Efrieza7/Cotxe_autonom/README_TOTAL.tex

\documentclass[11pt,a4paper]{article}

% Lletra Arial 11. Amb XeLaTeX o LuaLaTeX (a Overleaf: Menu > Compiler) es fa
% servir l'Arial de veritat; amb pdfLaTeX, Helvetica, que és pràcticament igual.
\usepackage{iftex}
\ifPDFTeX
  \usepackage[T1]{fontenc}
  \usepackage[utf8]{inputenc}
  \usepackage{lmodern}
  \usepackage[scaled=1]{helvet}
\else
  \usepackage{fontspec}
  \IfFontExistsTF{Arial}{\setsansfont{Arial}}{%
    \IfFontExistsTF{Liberation Sans}{\setsansfont{Liberation Sans}}{\setsansfont{TeX Gyre Heros}}}
\fi
\renewcommand{\familydefault}{\sfdefault}
\usepackage[spanish,es-noshorthands,english,catalan]{babel}
\usepackage{newunicodechar}
\usepackage[a4paper,margin=2cm,top=3.5cm,headheight=1.5cm,headsep=0.5cm]{geometry}
\usepackage{graphicx}
% Les imatges poden estar a la carpeta imatges/ o soltes al costat del .tex
\graphicspath{{imatges/}{./}}
\usepackage{booktabs}
\usepackage{float}
\usepackage{pdflscape}
\usepackage{amsmath}
\usepackage{xcolor}
\usepackage{listings}
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
\usepackage{setspace}
\usepackage{caption}
\usepackage[hidelinks]{hyperref}
% Els enllaços llargs es poden partir per qualsevol lloc i no surten del marge
\usepackage{xurl}

% Ela geminada (l·l) amb el punt volat ben ajustat
\newunicodechar{·}{\kern-0.12em\textperiodcentered\kern-0.12em}

% Lletres gregues dins del text
\newunicodechar{θ}{\ensuremath{\theta}}
\newunicodechar{δ}{\ensuremath{\delta}}
\newunicodechar{ω}{\ensuremath{\omega}}
\newunicodechar{Δ}{\ensuremath{\Delta}}

% Noms en català
\addto\captionscatalan{%
  \renewcommand{\contentsname}{ÍNDEX}%
  \renewcommand{\figurename}{Imatge}%
  \renewcommand{\listfigurename}{ÍNDEX D'IMATGES}%
  \renewcommand{\listtablename}{ÍNDEX DE TAULES}%
  \renewcommand{\refname}{BIBLIOGRAFIA}%
}

% Numeració fins a 4 nivells (p. ex. 4.2.4.1)
\setcounter{secnumdepth}{4}
\setcounter{tocdepth}{4}
% Títols com al README_TOTAL.md: les seccions amb una línia a sota
\titleformat{\section}{\normalfont\LARGE\bfseries}{\thesection}{0.6em}{}[{\vspace{-0.4ex}\titlerule}]
\titleformat{\subsection}{\normalfont\large\bfseries}{\thesubsection}{1em}{}
\titleformat{\subsubsection}{\normalfont\normalsize\bfseries\itshape}{\thesubsubsection}{1em}{}
\titleformat{\paragraph}{\normalfont\normalsize\itshape}{\theparagraph}{1em}{}
% Portada de cada bloc (Recerca, Electrònica, Mecànica, Programació)
\newcommand{\bloc}[1]{%
  \clearpage
  \refstepcounter{part}%
  \phantomsection
  \addcontentsline{toc}{part}{BLOC \thepart: #1}%
  \thispagestyle{empty}%
  \null\vfill
  \begin{center}
    {\Large\bfseries BLOC \thepart\par}
    \vspace{1em}
    {\Huge\bfseries #1\par}
  \end{center}
  \vfill\null
  \clearpage}
% Cada capítol comença en una pàgina nova (també si va just després d'un altre títol)
\let\origsection\section
\renewcommand{\section}{\clearpage\origsection}
\titlespacing*{\paragraph}{0pt}{3.25ex plus 1ex minus .2ex}{1.5ex plus .2ex}

% Capçalera de pàgina: logo de l'institut, nom del projecte i logo del cotxe
\usepackage{fancyhdr}
\usepackage{tabularx}
\pagestyle{fancy}
\fancyhf{}
% Tota la capçalera dins d'un requadre, amb línies verticals entre el logo
% de l'institut, el nom del projecte i el logotip del cotxe
\newcommand{\caplogo}[1]{\raisebox{-0.5\height}{\rule{0pt}{1.2cm}}\raisebox{-0.5\height}{}}
\fancyhead[C]{\begin{tabularx}{\headwidth}{|c|>{\centering\arraybackslash}X|c|}
  \hline
  \caplogo{logo_institut.png} & {\small\bfseries TREBALL DE RECERCA: COTXE AUTÒNOM} & \caplogo{logo_cotxe.png} \\
  \hline
\end{tabularx}}
\fancyfoot[C]{\thepage}
\renewcommand{\headrulewidth}{0pt}

% Cap paràgraf es parteix entre dues pàgines (tampoc després d'una equació)
\interlinepenalty=10000
% Una llista no comença a la pàgina següent de la frase que la presenta
\makeatletter\@beginparpenalty=10000\makeatother
\postdisplaypenalty=10000
\raggedbottom
% Les imatges i taules [H] queden sempre a la mateixa pàgina que el paràgraf
% d'abans. Amb \ambtextseguent dins de la figura, també amb el paràgraf de després.
\makeatletter
\newif\if@ambseguent
\newcommand{\ambtextseguent}{\global\@ambseguenttrue}
\renewcommand\float@endH{\@endfloatbox\penalty\@M\vskip\intextsep
  \if@flstyle\setbox\@currbox\float@makebox\columnwidth\fi
  \box\@currbox
  \if@ambseguent\penalty\@M\global\@ambseguentfalse\fi
  \vskip\intextsep\relax}
\makeatother

% Peus d'imatge i de taula en cursiva, com al README_TOTAL.md
\captionsetup{font=it,labelfont=it}

% Interlineat 1,15 i una línia en blanc entre paràgrafs
\setstretch{1.15}
\setlength{\parskip}{\baselineskip}
\setlength{\parindent}{0pt}
\setlength{\emergencystretch}{1em}

% Estil del codi
\lstdefinestyle{codi}{
  basicstyle=\ttfamily\small,
  keywordstyle=\color{blue!60!black}\bfseries,
  commentstyle=\color{green!40!black},
  stringstyle=\color{red!60!black},
  backgroundcolor=\color{gray!8},
  frame=single,
  rulecolor=\color{gray!40},
  breaklines=true,
  showstringspaces=false,
  columns=fullflexible,
  keepspaces=true,
  tabsize=4,
}
\lstset{style=codi}

\begin{document}

\hypersetup{pageanchor=false}
% Portada: logo de l'institut, títol, foto del cotxe i dades del treball
\newgeometry{margin=2cm}
\begin{titlepage}
  \setlength{\parskip}{0pt}
  \definecolor{granat}{HTML}{8B1E3F}
  \centering
  \par
  \vspace{2.5cm}
  {\color{granat}\rule{\textwidth}{1.5pt}\par}
  \vspace{0.8cm}
  {\Large\bfseries\color{gray!70!black} TREBALL DE RECERCA\par}
  \vspace{0.4cm}
  {\fontsize{40}{48}\selectfont\bfseries COTXE AUTÒNOM\par}
  \vspace{0.6cm}
  {\color{granat}\rule{\textwidth}{1.5pt}\par}
  \vspace{1.2cm}
  \par
  \vfill
  {\large\bfseries\color{granat} FET PER\par}
  \vspace{0.4em}
  {\large Sergi Rodríguez Garcia \enspace\textbullet\enspace Joan Pla Capdevila\\[0.2em]
    Enric Simó Benítez \enspace\textbullet\enspace Marcel Gonfaus Sant\par}
  \vspace{1.2cm}
  {\color{gray!50}\rule{\textwidth}{0.5pt}\par}
  \vspace{0.4em}
  \textbf{TUTOR:} Josep Maria Bergadà Fabregat\hfill\textbf{CURS:} 2n de Batxillerat, 2025-26\par
  \vspace{0.3em}
  Sabadell, 22 d’octubre de 2026\par
\end{titlepage}
\restoregeometry
\hypersetup{pageanchor=true}

{\setlength{\parskip}{0pt}\tableofcontents}
\clearpage

\section{ABSTRACT}

\subsection*{Castellà}
\begin{otherlanguage}{spanish}

El objetivo principal de este Trabajo de Investigación ha sido crear, a partir de los conocimientos de Bachillerato, un pequeño coche autónomo capaz de recorrer un circuito. Para llevar a cabo este proyecto se han usado conocimientos de programación, mecánica, electrónica, robótica e inteligencia artificial.

En la primera parte del trabajo se ha realizado una investigación sobre los coches autónomos y su evolución, con el objetivo de comprender su funcionamiento y adquirir los conocimientos necesarios para diseñar y construir nuestro propio coche autónomo. Posteriormente se han estudiado los recursos que se requieren para este trabajo, los componentes del coche y su chasis. Todo esto para poder desarrollar los programas para el vehículo.

Una vez finalizado el montaje, se han realizado diversas pruebas para comprobar que el coche funcione correctamente y corregir los errores cometidos en la parte de programación y de robótica.

En conclusión, este Trabajo de Investigación demuestra que, con los conocimientos adquiridos durante el Bachillerato, dedicación y mucho compromiso es posible crear un pequeño coche autónomo. Además, esta investigación ha permitido ampliar los conocimientos sobre programación, mecánica, robótica y poder comprender mejor el funcionamiento y las complejidades de los coches autónomos.

\end{otherlanguage}

\clearpage
\subsection*{Anglès}
\begin{otherlanguage}{english}

The main objective of this Research Project was to build a small autonomous car with the knowledge acquired during high school. The car was designed to go through a circuit without human assistance. To do this project, knowledge of programming, mechanics, electronics and artificial intelligence was used.

The first part of the work focused on researching autonomous cars and their evolution. The aim was to understand how they work and to acquire the knowledge needed to design and build our own autonomous car. Afterwards, the resources needed for the project, as well as the components of the car and the chassis were studied. All of this was done in order to develop the software for the car.

Once the building part was finished, several tests were carried out to make sure that the vehicle worked properly and to correct the errors that were found during testing.

To sum up, this Research Project demonstrates that, with the knowledge acquired during high school, a lot of dedication and perseverance it is possible to create a small autonomous car. Moreover, this investigation allowed us to expand our knowledge of programming, mechanics and robotics, while providing a better understanding of how autonomous vehicles work and their complexities.

\end{otherlanguage}

\section{INTRODUCCIÓ}

\subsection{La idea}

La idea de fer un projecte tan elaborat com el d’un cotxe autònom va sorgir d’una pluja d’idees en què volíem combinar diversos aspectes que agradessin a tots els membres del grup, com ara la programació, la mecànica o l’electrònica.

Al principi es va proposar fer un avió de control remot, però vam veure que s’havien d’aplicar molts conceptes nous que desconeixíem i vam decidir no fer-lo.

Quan es van presentar els treballs de recerca de 2n de batxillerat, n’hi va haver un que ens va cridar l’atenció a tots: un kart que es podia conduir. Va ser llavors quan ens va venir la idea de fer un cotxe que no estigués conduït per un humà sinó per un ordinador. Així que es va acordar que faríem un cotxe autònom fet per nosaltres des de zero.

\subsection{Sobre el projecte}

L’objectiu principal d’aquest treball és dissenyar i construir un cotxe autònom a escala capaç de recórrer un circuit delimitat per cons sense cap intervenció humana. La hipòtesi de partida és que, amb components de baix cost i els coneixements adquirits durant el batxillerat, és possible construir un vehicle que apliqui a petita escala els mateixos principis que fan servir els cotxes autònoms reals.

Els cotxes autònoms representen una de les tecnologies amb més potencial dins del sector de l'automoció. En els últims anys, empreses com Waymo, Tesla o Zoox han investigat i desenvolupat nombrosos prototips, fet que ha contribuït a l’evolució dels cotxes autònoms i ha despertat un gran interès per aquesta tecnologia. És un tema molt important, ja que podria reduir considerablement els accidents de trànsit produïts pels humans i millorar la conducció.

Aquest és un dels principals motius per a l’elecció d’aquest tema. A més, en els cotxes autònoms són essencials tots els àmbits que volíem combinar. I, com que som molt aficionats al món del motor i l’automobilisme, hem volgut que el disseny i la impressió 3D del cotxe fossin una part important del projecte. D’altra banda, vam pensar com es podria crear un cotxe autònom i quines dificultats ens causaria fer-lo.

\subsection{Organització}

Hem dividit el treball en quatre blocs principals, que corresponen a les diferents àrees que intervenen en un cotxe autònom:
\nopagebreak

\begin{itemize}
  \item \textbf{Recerca:} estudia què és un cotxe autònom, com ha evolucionat aquesta tecnologia i en quin punt es troba actualment. També analitza el que han fet diferents empreses del sector i fins a quin punt és viable aplicar aquesta tecnologia en el futur.
  \item \textbf{Electrònica:} analitza quins sensors existeixen, quins ens poden ser útils per al projecte i com s’han de connectar i alimentar perquè tot funcioni correctament.
  \item \textbf{Mecànica:} explica com funciona la mecànica d’un cotxe, especialment el sistema de direcció i la transmissió, i com hem dissenyat i fabricat les peces del nostre vehicle.
  \item \textbf{Programació:} explica com es programa un cotxe autònom i com hem utilitzat les dades dels diferents sensors perquè el vehicle es pugui localitzar, crear un mapa del circuit i seguir-lo.
\end{itemize}

Per assolir l’objectiu principal del treball, vam escollir les eines de cada bloc: Fusion 360 per al disseny 3D de les peces del cotxe, Inkscape per dissenyar el circuit, i ROS 2 i Python per a la programació.

Per dur a terme el treball, hem utilitzat una metodologia basada en la distribució de tasques segons les habilitats i els coneixements especialitzats de cada membre del grup. Els rols s’han assignat de la manera següent:
\nopagebreak

\begin{itemize}
  \item \textbf{Programació:} Enric
  \item \textbf{Mecànica:} Sergi
  \item \textbf{Electrònica i sensors:} Joan
  \item \textbf{Recerca de l’automobilisme autònom:} Marcel
\end{itemize}

Aquesta organització ens ha permès treballar durant l’estiu sense necessitat de fer reunions presencials constants, ja que cada membre ha pogut avançar en la seva àrea de manera independent.

Malauradament, cada integrant del grup ha tingut una manera diferent de treballar, i això es veu reflectit en el document: segons el bloc que es llegeixi, els continguts s’han explicat de maneres diferents.

Finalment, ens hem reunit per integrar les diferents parts del projecte, comprovar-ne la compatibilitat i posar en pràctica el sistema complet. Aquesta fase ha estat fonamental per coordinar la feina individual i aconseguir que tots els components funcionessin conjuntament.

\bloc{RECERCA}

\section{MARC TEÒRIC}

\subsection{Història dels cotxes autònoms}

Tot va començar l’any 1925, quan l’empresa nord-americana Houdina Radio Control va crear un cotxe sense ningú al volant. No es tractava d’un vehicle autònom, ja que estava controlat a través d’un sistema de radiocontrol, que funciona amb una persona que envia ordres de moviment i direcció a través d'un comandament.

Aquest projecte va inspirar moltes persones a imaginar noves possibilitats per al futur de l’automoció. Una d’aquestes persones va ser el dissenyador Norman Bel Geddes, qui l’any 1939 va presentar Futurama, una exposició on mostrava una possible ciutat del futur. En aquesta ciutat hi hauria milers de cotxes propulsats per camps electromagnètics i controlats automàticament. Tot això, amb l’objectiu de reduir els accidents a les carreteres.

Durant els anys següents, els avenços en informàtica, sensors i intel·ligència artificial van permetre desenvolupar sistemes autònoms cada cop més avançats. Durant les dècades dels vuitanta i noranta, Ernst Dickmanns, un professor i investigador alemany, va tenir un paper destacat en el desenvolupament d’aquestes tecnologies.

L’any 1987, Dickmanns va presentar el projecte VaMoRs. Es tractava de transformar una furgoneta Mercedes-Benz 508D en un vehicle autònom amb càmeres, sensors i un sistema informàtic molt avançat. Aquest prototip va arribar a velocitats de 90 km/h en autopistes alemanyes.

Anys més tard, el 1994, Dickmanns va crear el projecte VaMP, en el qual va modificar un cotxe Mercedes 500 SEL amb les tecnologies desenvolupades pel seu equip. El vehicle va dur a terme proves de llarga distància i va arribar a velocitats de 130 km/h pels afores de París. Gràcies a aquests avenços, la Comissió Europea va invertir en el projecte EUREKA Prometheus, un dels més importants sobre la conducció autònoma de l’època.

L’any 1995, Dickmanns va aconseguir unir Múnic amb Odense, Dinamarca, amb un Mercedes Classe S modificat. En total, el vehicle va recórrer més de 1.750 quilòmetres esquivant i avançant cotxes, tot de manera autònoma.

\begin{figure}[H]
  \centering
  
  \caption[{\protect\hyperref[imatge-1]{Projecte VaMP d'Ernst Dickmanns (Mercedes 500 SEL)}\protect\newline \textit{Font:} \protect\url{https://commons.wikimedia.org/wiki/File:VAMP.png}}]{Projecte VaMP d'Ernst Dickmanns (Mercedes 500 SEL)}\label{imatge-1}
\end{figure}

L’any 2004, DARPA, una agència nord-americana, va impulsar el desenvolupament dels vehicles autònoms amb la creació del DARPA Grand Challenge, una competició destinada a posar a prova diferents sistemes de navegació autònoma.

El 2009, Google va iniciar el seu projecte de vehicles autònoms, liderat inicialment per l’enginyer Sebastian Thrun, que havia participat anteriorment al DARPA Grand Challenge. En el projecte es van fer diverses proves amb vehicles equipats amb sensors, càmeres i sistemes informàtics capaços de detectar l’entorn i prendre decisions.

L’any 2015 Google va presentar Firefly, un prototip dissenyat per estudiar la conducció sense els controls convencionals d’un automòbil. Estava equipat amb diferents sensors i sistemes informàtics i anava sense volant ni pedals. Posteriorment, el projecte de Google es va convertir en Waymo, una empresa de tecnologia de conducció autònoma independent.

Waymo va continuar fent proves i desenvolupant els seus prototips, fins que l’any 2018 va llançar el seu servei de transport autònom en algunes zones determinades. Més endavant, el servei es va anar ampliant a més zones.

En conclusió, el desenvolupament dels cotxes autònoms ha estat progressiu i continuarà evolucionant a mesura que s’investiguin i desenvolupin noves tecnologies, amb l’objectiu de fer-los cada vegada més eficients i segurs.

\subsection{Què és un cotxe autònom?}

Els vehicles totalment automatitzats, també coneguts com a cotxes autònoms, són capaços de circular sense intervenció humana de manera continuada durant un període de temps. Per aconseguir-ho, utilitzen diverses tecnologies com sensors de percepció de l’entorn, càmeres, ordinadors i programes informàtics que els permeten prendre decisions. Són capaços de percebre l’exterior, interpretar-lo i prendre decisions en temps real per circular de manera segura.

\subsection{Com funciona un cotxe autònom?}

Per funcionar, els cotxes autònoms estan equipats amb diferents tecnologies que treballen conjuntament:
\nopagebreak

\begin{itemize}
  \item \textbf{Sensors de percepció de l'entorn:} a través de càmeres, radars, LiDAR i ultrasons, detecten possibles obstacles com ara vianants, cotxes i senyals de trànsit.
  \item \textbf{Sistemes de posicionament:} el GPS permet determinar la ubicació del vehicle.
  \item \textbf{Sistemes de comunicacions:} permeten intercanviar la informació necessària per a garantir una conducció automatitzada segura. Un exemple és la tecnologia V2X (\emph{Vehicle-to-everything}), que permet intercanviar informació amb altres vehicles, amb la infraestructura viària o amb altres elements de l’entorn.
  \item \textbf{Sistemes avançats de control:} gestionen les tasques del vehicle. Per exemple, per evitar que el cotxe perdi l’estabilitat s’utilitza el sistema de control electrònic d’estabilitat (ESC).
  \item \textbf{Sistemes d’aprenentatge automàtic:} també coneguts com a \emph{machine learning}, permeten aprendre de proves anteriors i prendre decisions per si mateixos sense ser programats amb instruccions fixes.
  \item \textbf{Algoritmes complexos:} formen part del programari que processa la informació recollida pels sensors. Per desenvolupar aquest programari es poden utilitzar diversos llenguatges com Python, C o C++, entre altres.
  \item \textbf{Controladors i actuadors:} reben instruccions del programari i controlen accions com la frenada, la direcció i l’acceleració.
  \item \textbf{Unitats de control i processadors:} executen el programari i transformen les dades dels sensors en ordres per al volant, l’accelerador i el fre.
\end{itemize}

En conjunt, aquestes tecnologies col·laboren per controlar el moviment del vehicle i realitzar les maniobres necessàries.

\subsection{Graus d’autonomia}

Segons la Societat d’Enginyers d’Automoció (SAE), hi ha sis nivells d’automatització, classificats segons el grau d’atenció i d’intervenció humana que es necessita durant la conducció, així com segons el desenvolupament i l’ús de les tecnologies utilitzades en el vehicle. Els sis nivells van del nivell 0 (manual) al nivell 5 (totalment automatitzat):
\nopagebreak

\textbf{GRAU 0 - MANUAL}

Conducció manual. El conductor s’encarrega de totes les tasques de conducció sense rebre l’ajuda de cap sistema complex.

\textbf{GRAU 1 - FEET OFF}

Conducció assistida. Un sistema d’assistència s’encarrega de controlar la direcció o l’acceleració, però no les dues alhora.

\textbf{GRAU 2 - HANDS OFF}

Automatització parcial. Un o diversos sistemes d’assistència controlen la direcció i l’acceleració.

\textbf{GRAU 3 - EYES OFF}

Automatització condicionada. Un sistema de conducció automatitzada realitza totes les tasques amb limitacions. El conductor ha d’estar pendent.

\textbf{GRAU 4 - MIND OFF}

Automatització alta. Un sistema de conducció automatitzada realitza totes les tasques de conducció.

\textbf{GRAU 5 - DRIVERLESS}

Automatització completa. Un sistema de conducció automatitzada realitza totes les tasques de conducció en qualsevol condició. No cal que el vehicle estigui equipat amb volant ni pedals.

\bloc{ELECTRÒNICA}

\section{SENSORS}

\subsection{LiDAR LD500}

El LiDAR LD500 serveix per saber a quina distància estan els objectes que hi ha al voltant del cotxe. Envia un làser i calcula el temps que triga a tornar després de rebotar contra un objecte.

En un cotxe autònom, s’utilitza principalment per detectar obstacles i evitar col·lisions. També ajuda el cotxe a saber com és l’espai que té al seu voltant.

Les característiques tècniques completes es poden consultar a la fitxa tècnica del component\footnote{\url{https://files.waveshare.com/wiki/D500-LiDAR-Kit/LDROBOT_STL-19P_Datasheet_EN_v1.0(1).pdf}}.

\subsection{Sense HAT 1.0.0}

El Sense HAT 1.0.0 és una placa que es pot connectar a una Raspberry Pi i que té diferents sensors. En un cotxe autònom pot servir per obtenir informació sobre el moviment i les condicions de l’entorn.

Té sensors per mesurar la temperatura, la pressió i la humitat, i també té una IMU, que és un sensor que detecta el moviment, la inclinació i la direcció del cotxe. De tots aquests sensors, en aquest projecte només s’utilitza la IMU; els de temperatura, pressió i humitat no es fan servir.

Les característiques tècniques completes es poden consultar a la fitxa tècnica del component\footnote{\url{https://pip-assets.raspberrypi.com/categories/676-raspberry-pi-sense-hat/documents/RP-008384-DS-1-sense-hat-product-brief.pdf}}.

\subsection{Sensors de proximitat HC-SR04 Pro}

L’HC-SR04 Pro és un sensor de distància per ultrasons. Emet un pols d’ultrasons i mesura el temps que triga a tornar l’eco després de rebotar contra un objecte. A partir d’aquest temps, i coneixent la velocitat del so, es pot calcular a quina distància es troba l’obstacle.

En el nostre cotxe n’hi ha dos, i s’utilitzen en el sistema de seguretat del control de la direcció per detectar parets o obstacles propers si la resta del sistema falla.

Les característiques tècniques completes es poden consultar a la fitxa tècnica del component\footnote{\url{https://sigmanortec.ro/en/ultrasonic-sensor-hc-sr-04p-3-55v}}.

\section{ACTUADORS}

\subsection{Motor GA12-N20 Encoder DC}

El GA12-N20 Encoder DC és un motor petit que serveix per fer girar les rodes del cotxe. Està format per un motor de corrent continu i un \emph{encoder}.

L’\emph{encoder} permet saber com està girant el motor, per exemple la seva velocitat i quantes voltes ha fet. Això és útil en un cotxe autònom perquè permet controlar millor el moviment i fer que el cotxe avanci a la velocitat desitjada.

Les característiques tècniques completes es poden consultar a la fitxa tècnica del component\footnote{\url{https://es.scribd.com/document/388716290/GA12-N20}}.

\subsection{Servomotor MG90S}

El servomotor MG90S és un petit motor que es controla mitjançant impulsos elèctrics: la durada de cada impuls indica la posició a la qual ha de girar, cosa que permet controlar amb precisió quants graus gira.

En el nostre cotxe, s’ha utilitzat per controlar la direcció de les rodes.

Les característiques tècniques completes es poden consultar a la fitxa tècnica del component\footnote{\url{https://towerpro.com.tw/product/mg90s-3/}}.

\section{CONTROLADORS}

\subsection{Raspberry Pi 4}

La Raspberry Pi 4 és el component principal que controla el cotxe. Rep la informació dels sensors, la processa i decideix què ha de fer el cotxe.

Per exemple, pot rebre informació del LiDAR i detectar que hi ha un obstacle. En aquest cas, pot enviar una ordre als motors perquè el cotxe freni o canviï de direcció.

Les característiques tècniques completes es poden consultar a la fitxa tècnica del component\footnote{\url{https://pip-assets.raspberrypi.com/categories/545-raspberry-pi-4-model-b/documents/RP-008341-DS-1-raspberry-pi-4-datasheet.pdf}}.

\subsection{Driver DRV8833}

El DRV8833 és un controlador (doble pont H) que serveix per controlar els motors. La Raspberry Pi envia les ordres al \emph{driver} i aquest controla la velocitat i el sentit de gir dels motors. No té pin de PWM separat: la velocitat es controla aplicant el PWM directament a les entrades xIN1/xIN2.

\begin{table}[H]
  \ambtextseguent
  \centering
  \caption{Connexions del DRV8833 i de l'encoder}\label{taula-1}
  \begin{tabular}{ll}
    \toprule
    \textbf{Senyal} & \textbf{GPIO (BCM)} \\
    \midrule
    AIN1 (motor A, amb encoder) & 5 \\
    AIN2 (motor A) & 6 \\
    BIN1 (motor B, sense encoder) & 26 \\
    BIN2 (motor B) & 16 \\
    Encoder fase A & 27 \\
    Encoder fase B & 17 \\
    \bottomrule
  \end{tabular}
\end{table}

El pin STBY (nSLEEP) del DRV8833 està connectat a VM, de manera que el \emph{driver} està sempre habilitat i no ocupa cap GPIO.

Això permet que el cotxe pugui avançar i anar enrere.

Les característiques tècniques completes es poden consultar a la fitxa tècnica del component\footnote{\url{https://www.ti.com/lit/ds/symlink/drv8833.pdf}}.

\section{ALIMENTACIÓ}

En aquest apartat es descriuen els components que proporcionen i regulen l’energia de tot el cotxe.

\subsection{Bateries OVONIC LiPo}

Les bateries OVONIC LiPo són les que proporcionen l’energia necessària perquè funcioni el cotxe. Alimenten els motors, la Raspberry Pi i la resta de components.

Les bateries LiPo tenen una bona relació entre pes i capacitat, per això són molt utilitzades en vehicles petits, drons i projectes de robòtica.

Tot i això, són perilloses i s’han de manipular amb molta precaució, ja que un curtcircuit pot fer que la bateria s’escalfi molt ràpidament i acabi explotant.

Les característiques tècniques completes es poden consultar a la fitxa tècnica del component\footnote{\url{https://www.ovonicshop.com/}}.

\subsection{Hobbywing BEC}

El Hobbywing BEC serveix per regular el voltatge que arriba als diferents components. La bateria dona una tensió que pot ser massa alta per a alguns components, i el BEC l’adapta perquè puguin funcionar correctament.

Així ajuda a protegir la Raspberry Pi i els altres components del cotxe.

Les característiques tècniques completes es poden consultar a la fitxa tècnica del component\footnote{\url{https://www.hobbywing.com/en/products/ubec-5a93}}.

\section{ESQUEMA DE CONNEXIONS}

Perquè tant els sensors com els controladors i els actuadors puguin funcionar, han d'estar tots ben connectats i ben alimentats. Per això el mapa de connexions és important. L'esquema complet es troba a l'\hyperref[annex-3]{Annex 3}.

Com es pot veure a l'esquema, la bateria va connectada directament al regulador (BEC), que en redueix la tensió a 5 V. Del regulador surten tres cables de 5 V i tres de GND. Una parella va a la Raspberry (pins 4 i 6), una altra al servomotor i l'última al \emph{driver} dels motors (DRV8833). Tant el Sense HAT com el LiDAR s'alimenten de la Raspberry, ja que no demanen gaire corrent.

El LiDAR està connectat a un adaptador USB-UART que permet connectar-lo a la Raspberry per USB. El Sense HAT, en canvi, va muntat directament a sobre del connector de 40 pins de la Raspberry.

Els motors es connecten a les sortides del \emph{driver}: el motor B a BOUT1 i BOUT2, i el motor A a AOUT1 i AOUT2. A més, el motor A té un \emph{encoder} per mesurar la velocitat de gir. L'\emph{encoder} envia els seus dos senyals als GPIO 27 (fase A, pin 13) i 17 (fase B, pin 11), s'alimenta amb els 3,3 V del pin 1 i té el GND connectat al pin 25. Finalment, la Raspberry controla el \emph{driver} a través de les entrades AIN1, AIN2, BIN1 i BIN2 (vegeu la Taula 1).

El servomotor, a part de l'alimentació, només té un cable, pel qual rep el senyal. Aquest cable està connectat al GPIO 4 (pin 7).

Els dos sensors de proximitat s'alimenten amb els 3,3 V del pin 17 i tenen el GND connectat al pin 39. Cada sensor utilitza dos GPIO: un per al Trig, que envia el pols d'ultrasons, i un altre per a l'Echo, que retorna el temps que triga l'eco. El primer sensor té el Trig al GPIO 13 (pin 33) i l'Echo al GPIO 19 (pin 35), i el segon té el Trig al GPIO 20 (pin 38) i l'Echo al GPIO 21 (pin 40).

\bloc{MECÀNICA}

\section{DESENVOLUPAMENT DEL DISSENY}

\subsection{El disseny}

\subsubsection{Inspiració del disseny del cotxe}

El disseny del cotxe es va basar en diversos xassís de cotxes vistos des de dalt per saber la forma i l’estructura que tenen. Més endavant, mentre es dissenyava en CAD, el disseny dibuixat originalment es va anar modificant fins a obtenir-ne una versió millorada i amb aspectes més innovadors.

\subsubsection{Programes de disseny 3D}

Avui en dia, hi ha molts programes de disseny i modelatge 3D, com ara FreeCAD, Tinkercad, Blender o Fusion 360. Alguns ja els havíem fet servir en cursos anteriors, però per fer aquest treball calien moltes funcions especials, així que hem optat per Fusion 360.

Fusion 360 és un programa de modelatge i disseny 3D amb llicència de pagament o pla gratuït, que fan servir empreses molt conegudes com Airbus o SpaceX per als seus prototips.

Hem triat aquest programa principalment per la practicitat i la varietat d’opcions que ens dona a l’hora de modelar i pel que fa a importar i exportar models 3D.

Aquí hi ha una taula comparativa dels programes:

\begin{table}[H]
  \centering
  \caption{Comparativa dels programes de disseny 3D}\label{taula-2}
  \begin{tabular}{lll}
    \toprule
    \textbf{Programa} & \textbf{Avantatges} & \textbf{Inconvenients} \\
    \midrule
    Tinkercad & Fàcil & Massa limitat \\
    FreeCAD & Gratuït i de codi obert & Interfície poc intuïtiva \\
    Blender & Molt potent & Poc orientat a enginyeria \\
    Fusion 360 & Paramètric i tècnic & Corba d’aprenentatge alta \\
    \bottomrule
  \end{tabular}
\end{table}

\subsubsection{Com ha anat avançant?}

Quan vam començar a fer l’esbós inicial, no vam preveure alguns errors, com el mecanisme de gir i l’espai que necessitaria, la posició del diferencial o com aniria connectat el motor, entre altres problemes d’ubicació i d’estètica.

\subsubsection{Imprevistos i millores en els prototips}

Mentre s’anava dissenyant, vam començar a fer prototips sencers del que seria el resultat final amb les impressores proporcionades per l’escola, però, com en tot projecte elaborat, es van detectar diversos aspectes de millora.

\paragraph*{Prototip \#1}

En el primer prototip el vehicle estava separat en dues parts. Aquesta configuració feia que l'estructura fos més propensa a enfonsar-se o deformar-se si havia de suportar massa pes a la part superior.

També es va provar de fabricar una reductora d'engranatges pròpia. Tot i això, el disseny dels engranatges no era correcte i aquests lliscaven entre ells, de manera que no transmetien el moviment correctament.

A partir d'aquests problemes es van decidir diverses modificacions.

En primer lloc, es va passar a fabricar el xassís en una sola peça, amb l'objectiu d'aconseguir una estructura més resistent. També es van reforçar algunes parts que podien acabar trencant-se amb l'ús.

Per al sistema de transmissió es va abandonar la reductora d'engranatges que s'havia dissenyat inicialment i es va passar a utilitzar un motor reductor.

\paragraph*{Prototip \#2}

En el segon prototip es van continuar fent modificacions a partir dels problemes i limitacions detectats anteriorment.

Es va decidir canviar el motor reductor usat anteriorment pel motor que es fa servir actualment, un motor GA12-N20 amb \emph{encoder} de 6 V.

També es va modificar la geometria del vehicle per millorar el sistema de gir i es va augmentar una mica la batalla del vehicle. A més, es va augmentar l'amplada de les rodes.

Un altre canvi important va ser la creació d'una nova peça en forma de L, dissenyada per connectar el servomotor amb la barra metàl·lica del sistema de direcció.

Aquestes modificacions es van fer amb l'objectiu de millorar la integració dels diferents elements mecànics i aconseguir un sistema de direcció més adequat per al vehicle.

\paragraph*{Prototip \#3}

En el tercer prototip, s’ha augmentat la llargada del cotxe a causa de la incorporació de sensors ultrasònics a la part posterior, i s’ha fet un suport per al LiDAR just a sobre del tren de direcció.

Finalment, hem col·locat dos motors per tenir més parell i una relació de transmissió de 2,5 voltes de roda per cada volta dels motors, junt amb un compartiment a la part inferior del cotxe per a la bateria.

\subsection{El resultat final}

En aquest apartat, es pot veure el resultat final del cotxe imprès i les seves dades.

\begin{figure}[H]
  \centering
  
  \caption[{\protect\hyperref[imatge-2]{Model final del cotxe}\protect\newline \textit{Fotografia pròpia}}]{Model final del cotxe}\label{imatge-2}
\end{figure}

\begin{table}[H]
  \centering
  \caption{Dimensions del cotxe}\label{taula-3}
  \begin{tabular}{ll}
    \toprule
    \textbf{Característica} & \textbf{Mesura} \\
    \midrule
    Longitud & 330 mm \\
    Amplada & 130 mm \\
    Distància entre eixos & 176,8 mm \\
    Amplada entre rodes & 130 mm \\
    Diàmetre de les rodes & 56 mm \\
    Alçada & 115 mm \\
    \bottomrule
  \end{tabular}
\end{table}

\section{MECANISMES}

Per poder fer que el cotxe realitzi algunes de les seves funcions bàsiques, com ara girar o moure’s, fan falta una sèrie de mecanismes que són emprats als cotxes reals.

\subsection{Geometria d’Ackermann}

Per al sistema de direcció del vehicle es va utilitzar una geometria basada en el principi d'Ackermann.

La geometria d'Ackermann permet que, quan el vehicle gira, la roda interior faci una trajectòria de radi menor que la roda exterior. Per aquest motiu, les dues rodes davanteres no han de girar exactament el mateix angle.

Aquesta geometria permet millorar el comportament del vehicle durant els girs i reduir el lliscament de les rodes.

En el nostre vehicle, aquest sistema es va integrar amb un servomotor que permet controlar el moviment de la direcció.

\begin{figure}[H]
  \ambtextseguent
  \centering
  
  \caption[{\protect\hyperref[imatge-3]{Geometria d'Ackermann}\protect\newline \textit{Imatge modificada. Font:} \protect\url{https://es.wikipedia.org/wiki/Archivo:Ackermann.svg}}]{Geometria d'Ackermann (modificada)}\label{imatge-3}
\end{figure}

Com es pot veure en la imatge, l’angle de la roda interior ($\theta_1$) és més gran que el de l’exterior ($\theta_2$).

En aquesta captura, es pot apreciar la geometria d’Ackermann des de Fusion 360.

\begin{figure}[H]
  \ambtextseguent
  \centering
  
  \caption[{\protect\hyperref[imatge-4]{Geometria d'Ackermann del nostre cotxe}\protect\newline \textit{Captura de Fusion 360}}]{Geometria d'Ackermann del nostre cotxe. Feta des de Fusion 360.}\label{imatge-4}
\end{figure}

El que està en vermell és on van connectades les rodes, el braç lila és on van unides les dues peces vermelles i la palanca blava és on van connectats el servomotor i el braç lila per poder girar.

\subsection{Aplicació de l’arquitectura d’Ackermann}

El sistema que es va utilitzar en el primer prototip era un sistema pinyó-cremallera. Però es va decidir canviar-lo perquè no funcionava com es necessitava. Posteriorment es va optar per utilitzar una barra articulada connectada al servomotor, la qual és travessada per uns fixadors que s’enrosquen a les parts blaves i vermelles de la imatge següent.

El servomotor permetia controlar la posició de la direcció i estava connectat mecànicament a una barra metàl·lica que transmetia el moviment a les rodes a través d’una barra que transformava la rotació del servomotor en moviment lineal.

La versió final ha quedat així:

\begin{figure}[H]
  \ambtextseguent
  \centering
  
  \caption[{\protect\hyperref[imatge-5]{Transmissió Ackermann-servomotor}\protect\newline \textit{Captura de Fusion 360}}]{Transmissió Ackermann-servomotor. Feta des de Fusion 360.}\label{imatge-5}
\end{figure}

Tot i que el sistema anterior semblava que funcionaria, era molt poc precís i no tenia prou força per poder girar correctament. Així que hem decidit canviar el mecanisme.

D'aquesta manera, el moviment del servomotor es transmet directament a la barra de gir i aquesta produeix el moviment de les rodes. El servomotor va instal·lat sobre la direcció, perquè d’aquesta manera es produeix un moviment més precís i directe.

\begin{figure}[H]
  \ambtextseguent
  \centering
  
  \caption[{\protect\hyperref[imatge-6]{Instal·lació final del servomotor}\protect\newline \textit{Captura de Fusion 360}}]{Instal·lació final del servomotor. Feta des de Fusion 360.}\label{imatge-6}
\end{figure}

\subsection{Transmissió del diferencial}

El grup diferencial d’un vehicle terrestre es va crear el 1827 per als cotxes impulsats a vapor. Servia per transmetre la força del motor als eixos de les rodes de forma asimètrica quan el vehicle girava en un revolt.

Avui dia s’utilitza en tots els vehicles terrestres (excepte motocicletes) i fa la mateixa funció que fa gairebé dos-cents anys, tot i que s’ha anat millorant al llarg dels anys.

Hem volgut aplicar-lo al nostre cotxe per la mateixa raó que la geometria d’Ackermann i perquè així sigui més estable i no derrapi als revolts fent que la roda de l’exterior giri més de pressa que la de l’interior.

Consta d’un conjunt d’engranatges anomenats planetaris, inserits dins d’una caixa metàl·lica i girats 90° entre ells, i una corona (un engranatge més gran) que està unida a la caixa. El moviment rotatori del motor es transmet a través d’un pinyó d’atac, que està connectat a 90° de la corona.

\begin{figure}[H]
  \ambtextseguent
  \centering
  
  \caption[{\protect\hyperref[imatge-7]{Funcionament del diferencial}\protect\newline \textit{Imatge modificada. Font:} \protect\url{https://www.motor.mapfre.es/consejos-practicos/consejos-de-mantenimiento/diferencial-coche/}}]{Funcionament del diferencial (modificada)}\label{imatge-7}
\end{figure}

Aquest és el nostre diferencial extret de Makerworld\footnote{Makerworld és una pàgina web on pots penjar i trobar dissenys per imprimir en 3D de forma gratuïta.} i modificat per nosaltres gràcies a lu\_print.

\subsection{Aplicació del diferencial}

En el nostre cas, el diferencial es va fer amb impressió 3D. El model inicial es va modificar per adaptar-lo al nostre vehicle. Es va fer un forat en cada un dels engranatges que van connectats als eixos de les rodes, ja que s’han utilitzat unes barres metàl·liques per transmetre el moviment directament a les rodes.

Aquesta modificació va permetre adaptar el diferencial al sistema de muntatge del nostre cotxe. Aquí es pot veure com ha quedat en el prototip final:

\begin{figure}[H]
  \centering
  
  \caption[{\protect\hyperref[imatge-8]{Diferencial del prototip final}\protect\newline \textit{Fotografia pròpia}}]{Diferencial del prototip final}\label{imatge-8}
\end{figure}

\section{IMPRESSORES 3D}

Per poder realitzar aquest projecte, s’han hagut d’utilitzar impressores 3D per crear-ho tot, des de les rodes fins al xassís. Hem fet servir impressores 3D de filament, ja que són les més adequades per fer el treball.

\subsection{Com funcionen?}

Una impressora 3D de filament diposita plàstic fos sobre una superfície llisa i calenta. El capçal, mogut per motors pas a pas i corretges, controla el flux de plàstic i la seva posició.

Aquest procés el va fent capa per capa fins que la peça està completada.

La màquina llegeix un codi escrit en G-code\footnote{El G-code és un llenguatge de programació utilitzat per controlar màquines automàtiques com impressores 3D, fresadores CNC, talladores làser i torns. Actua com un traductor que converteix un model digital en una sèrie d'instruccions que són les que llegeix la màquina.} generat per un laminador a partir de la peça que es vol imprimir. Aquest codi es descarrega o s’envia a la impressora per Wi-Fi, i la impressora imprimeix la peça automàticament.

\subsection{Quina impressora 3D hem utilitzat?}

Avui en dia, hi ha un gran ventall de marques d’impressores 3D, com ara Prusa, Creality o Bambu Lab. A la nostra disposició teníem la Bambu Lab H2D i la Bambu Lab P1S, les quals són de les impressores 3D més conegudes del mercat actual.

Tenen una qualitat i una rapidesa d’impressió excepcionals, cosa que ens garanteix una bona impressió i menys errades gràcies als seus sistemes d’intel·ligència artificial i CoreXY. El CoreXY és un sistema en què el capçal de la impressora es controla amb dos motors pas a pas independents i corretges.

La H2D es va utilitzar principalment per fabricar el xassís i les rodes, mentre que la P1S es va utilitzar per als engranatges, prototips petits i altres peces.

La utilització de dues impressores va permetre repartir la fabricació de les diferents peces segons les necessitats de cada impressió.

\subsubsection{Bambu Lab P1S}

La Bambu Lab P1S és una de les primeres impressores tancades que va fer Bambu Lab, i incorpora la tecnologia CoreXY. Destaca per la facilitat de muntatge, velocitat i fiabilitat. Inclou un volum d’impressió estàndard de 256 x 256 x 256 mm i porta un filtre de carboni per captar partícules perilloses en escalfar materials tècnics com l’ABS.

Només té un \emph{nozzle} (extrusor per on surt el filament plàstic desfet) i per canviar de color o material s’ha de fer manualment o utilitzar el sistema AMS (de l’anglès Automatic Material System), que ho fa automàticament.

\begin{figure}[H]
  \centering
  
  \caption[{\protect\hyperref[imatge-9]{Bambu Lab P1S}\protect\newline \textit{Font:} \protect\url{https://eu.store.bambulab.com/en/products/p1s}}]{Bambu Lab P1S}\label{imatge-9}
\end{figure}

\subsubsection{Bambu Lab H2D}

La Bambu Lab H2D és una de les primeres impressores tancades tot en un de tipus industrial, i incorpora la tecnologia CoreXY millorada respecte de la P1S.

Destaca per ser una plataforma híbrida de fabricació que combina impressió 3D ultraràpida, gravat i tall làser, i traçat a paper. Inclou un volum d’impressió molt més ampli, de 350 x 320 x 325 mm, i porta un potent sistema de ventilació amb filtre de carboni i cambra calefactada activa a 65 °C per treballar de manera segura amb materials tècnics avançats a altes temperatures.

A diferència de models anteriors, compta amb un doble \emph{nozzle} (dos extrusors independents), la qual cosa permet combinar materials rígids i flexibles com el TPU sense embussos.

\begin{figure}[H]
  \centering
  
  \caption[{\protect\hyperref[imatge-10]{Bambu Lab H2D}\protect\newline \textit{Font:} \protect\url{https://eu.store.bambulab.com/en/products/h2d}}]{Bambu Lab H2D}\label{imatge-10}
\end{figure}

\subsection{Paràmetres d’impressió}

Per a les impressions realitzades es van utilitzar principalment els següents paràmetres:

\begin{table}[H]
  \centering
  \caption{Paràmetres d'impressió}\label{taula-4}
  \begin{tabular}{ll}
    \toprule
    \textbf{Paràmetre} & \textbf{Valor} \\
    \midrule
    Alçada de capa & 0,2 mm \\
    Infill & 15 \% \\
    Nombre de parets & 3 \\
    Temperatura PLA & 220 °C \\
    Temperatura PETG & 255 °C \\
    Suports & Sí, en el xassís \\
    \bottomrule
  \end{tabular}
\end{table}

L’alçada de capa és la separació que hi ha entre les capes de les peces.

L’\emph{infill} (o farciment) és l’estructura interna de la peça: per estalviar temps i material, es genera un patró que suporta tota la peça i fa que sigui més resistent.

El nombre de parets és la quantitat de capes de plàstic que formen el contorn exterior de la peça, separant la superfície de l’\emph{infill} intern.

Els suports són estructures provisionals que aguanten les parts de la peça que queden suspeses a l’aire o tenen molta inclinació; sense ells, les peces sortirien malament.

\section{MATERIALS UTILITZATS}

La impressió 3D utilitza una gran varietat de materials, cadascun dels quals s’adapta a diferents tecnologies i aplicacions, des de la rapidesa i facilitat d'ús fins a la resistència mecànica o tèrmica.

\subsection{Quins materials teníem disponibles?}

Per poder realitzar el nostre projecte usant impressores 3D, teníem tres opcions:
\nopagebreak

\begin{itemize}
  \item \textbf{PLA (Àcid Polilàctic):} El material més comú i fàcil d'imprimir, s’imprimeix de 180 a 220 °C i és biodegradable. És ideal per a maquetes, decoració i prototips ràpids, però és poc resistent a la calor.
  \item \textbf{PETG (Polietilè tereftalat de glicol):} Té la facilitat d’impressió del PLA amb la resistència del material de les ampolles de plàstic, s’imprimeix de 220 a 255 °C. És més flexible que el PLA, resistent a l'aigua i als impactes.
  \item \textbf{ABS (Acrilonitril butadiè estirè):} Molt resistent i durador, aguanta bé les altes temperatures i es pot polir amb acetona, s’imprimeix de 230 a 250 °C. Requereix impressora tancada per evitar que es deformi durant la impressió.
\end{itemize}

\subsection{Materials per a cada peça}

Els principals materials utilitzats en la fabricació van ser PLA i PETG.

El PLA utilitzat era de Bambu Lab i Creality, mentre que el PETG utilitzat era de Creality.

La distribució dels materials va ser la següent:

\begin{table}[H]
  \ambtextseguent
  \centering
  \caption{Materials per a cada peça}\label{taula-5}
  \begin{tabular}{ll}
    \toprule
    \textbf{Peça} & \textbf{Material} \\
    \midrule
    Xassís & PLA \\
    Rodes & PLA \\
    Diferencial & PETG \\
    Engranatges & PETG \\
    Suports & PLA \\
    Altres peces & PLA \\
    \bottomrule
  \end{tabular}
\end{table}

El PLA es va utilitzar principalment en peces estructurals i altres parts del vehicle, mentre que el PETG es va utilitzar en peces que formen part del sistema de transmissió, com el diferencial i els engranatges.

\bloc{PROGRAMACIÓ}

\section{EXPLICACIÓ DE ROS 2}

ROS 2 (Robot Operating System 2) és un \emph{framework} de programari dissenyat principalment per al desenvolupament de sistemes robòtics. Permet executar diversos programes de manera simultània, compartir dades entre aquests programes i establir comunicació entre els diferents components del sistema.

ROS 2 funciona principalment mitjançant un sistema de \emph{nodes} i \emph{topics}. Cada \emph{node} és un programa que realitza una determinada funció, mentre que els \emph{topics} són canals de comunicació que permeten transmetre dades entre els diferents \emph{nodes}.

Un \emph{node} pot publicar dades en un \emph{topic}, és a dir, enviar informació, o pot estar subscrit a un \emph{topic}, de manera que rep les dades que es publiquen en aquest canal. D'aquesta manera, diferents programes poden treballar de forma independent però compartir la informació necessària.

A més dels \emph{nodes} i els \emph{topics}, un projecte de ROS 2 necessita una determinada estructura d'arxius i directoris perquè pugui ser compilat i executat correctament. Alguns directoris, com \texttt{build}, \texttt{install} i \texttt{log}, són generats automàticament durant el procés de compilació amb \texttt{colcon build}, que és la comanda per compilar els repositoris de ROS 2.

D'altra banda, hi ha arxius que formen part de l'estructura del paquet i que han de ser configurats pel programador. Entre aquests es troben \texttt{package.xml}, \texttt{setup.py} i, segons el tipus de paquet, \texttt{CMakeLists.txt}. També existeixen directoris com \texttt{src}, on es troba el codi font del projecte, i els diferents directoris interns del paquet.

En aquest projecte s'ha utilitzat la versió ROS 2 Jazzy. La guia oficial per instal·lar-la es pot trobar a: \href{https://docs.ros.org/en/jazzy/Installation.html}{Instal·lació de ROS 2 Jazzy}.

\begin{figure}[H]
  \centering
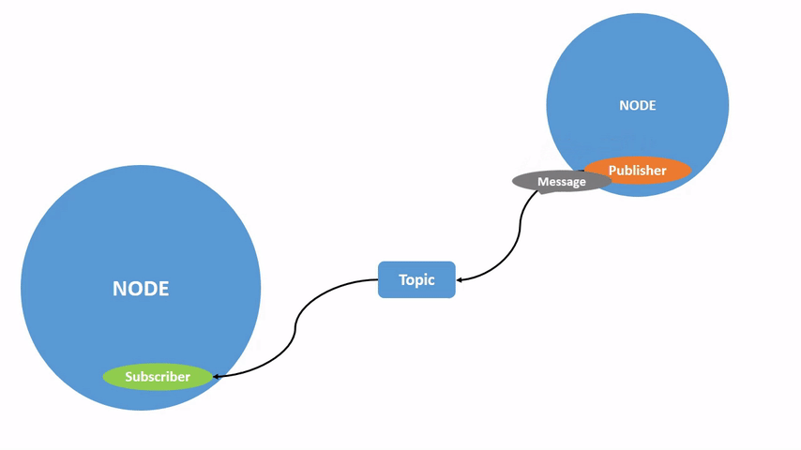
[picture p14: imatges/imatge_08_ros2_nodes_topics.png]
  
  \caption[{\protect\hyperref[imatge-11]{Exemple simple del funcionament de ROS 2}\protect\newline \textit{Font:} \protect\url{https://docs.ros.org/en/jazzy/Tutorials/Beginner-CLI-Tools/Understanding-ROS2-Topics/Understanding-ROS2-Topics.html}}]{Exemple simple del funcionament de ROS 2}\label{imatge-11}
\end{figure}

\subsection{Estructura d’un node}

El codi complet d'aquest exemple es troba a l'\hyperref[annex-1]{Annex 1}.

Aquest exemple mostra l’estructura bàsica d’un \emph{node} de ROS 2 desenvolupat en Python.

En primer lloc es troben els \emph{imports}, que incorporen les biblioteques i els tipus de missatge necessaris. En aquest cas, \texttt{rclpy} proporciona les eines necessàries per treballar amb ROS 2, \texttt{Node} permet crear el \emph{node} i \texttt{String} és el tipus de missatge utilitzat.

\begin{lstlisting}[language=Python]
import rclpy
from rclpy.node import Node
from std_msgs.msg import String
\end{lstlisting}

A continuació es defineix la classe del \emph{node}, que hereta de \texttt{Node}. Aquesta classe conté els elements que determinen el comportament del \emph{node}.

\begin{lstlisting}[language=Python]
class MyNode(Node):
\end{lstlisting}

El mètode \texttt{\_\allowbreak{}\_\allowbreak{}init\_\allowbreak{}\_\allowbreak{}()} és el constructor i s’executa quan es crea una instància del \emph{node}. En aquest apartat es configura el \emph{node} i es creen els elements de comunicació. En l’exemple es crea un \emph{subscriber}, que rep missatges del \emph{topic} \texttt{my\_\allowbreak{}topic}, i un \emph{publisher}, que permet publicar-hi missatges.

\begin{lstlisting}[language=Python]
    def __init__(self):
        super().__init__('my_node')

        self.subscription = self.create_subscription(
            String,
            'my_topic',
            self.listener_callback,
            10
        )
        self.publisher = self.create_publisher(
            String,
            'my_topic',
            10
        )
\end{lstlisting}

El \emph{subscriber} està associat a la funció \texttt{listener\_\allowbreak{}callback()}. Aquesta funció és un \emph{callback}, és a dir, una funció que ROS 2 executa quan es rep un missatge en el \emph{topic} al qual el \emph{node} està subscrit. És on es troba el codi executable com a tal.

\begin{lstlisting}[language=Python]
    def listener_callback(self, msg):
        print('Missatge rebut:', msg.data)
\end{lstlisting}

\newpage
Finalment, la funció \texttt{main()} s’encarrega de la inicialització i execució del \emph{node}.

\begin{lstlisting}[language=Python]
def main(args=None):
    rclpy.init(args=args)

    node = MyNode()
    rclpy.spin(node)
    node.destroy_node()
    rclpy.shutdown()
\end{lstlisting}

\section{PLANIFICACIÓ DEL CODI}

El sistema segueix la idea d’un SLAM (\emph{Simultaneous Localization and Mapping}): el cotxe calcula on és mentre construeix el mapa del circuit. El codi està dividit en quatre blocs, i cada bloc està format per diversos \emph{nodes} de ROS 2 que s’envien la informació a través de \emph{topics}:
\nopagebreak

\begin{enumerate}
  \item \textbf{Localització:} calcula la posició i l’orientació del cotxe a partir de la velocitat de les rodes (\emph{encoder}), de la IMU i de l’angle de direcció, utilitzant el Bicycle Model.
  \item \textbf{Mapatge:} llegeix el LiDAR, converteix les lectures en punts del pla, detecta els cons i els afegeix a un mapa global. Amb aquests cons també corregeix la posició calculada per la localització.
  \item \textbf{Planificació de la trajectòria (\emph{path plan}):} a partir del mapa de cons, calcula la traçada que ha de seguir el cotxe pel mig del circuit.
  \item \textbf{Control:} fa que el cotxe segueixi aquesta traçada: calcula l’angle de direcció (Pure Pursuit), manté la velocitat objectiu (PID) i envia les ordres al servomotor i als motors.
\end{enumerate}

A més, hi ha un sistema de seguretat amb sensors de proximitat que pot corregir la direcció si els altres blocs fallen.

Resumint, la informació circula així:
\nopagebreak

\begin{center}
  sensors $\rightarrow$ localització $\rightarrow$ mapatge $\rightarrow$ \emph{path plan} $\rightarrow$ control $\rightarrow$ motors i servo
\end{center}

Cada vegada que el LiDAR completa una volta, aquest cicle es repeteix, de manera que el cotxe treballa sempre amb les dades més recents. Als apartats següents s’explica cada bloc amb detall, i a l’apartat \ref{sec:organitzacio-global} es pot veure l’esquema complet de com es connecten tots els \emph{nodes}.

\section{LOCALITZACIÓ}

Aquest bloc s’encarrega de localitzar el cotxe i està format pels \emph{nodes}:
\nopagebreak

\begin{itemize}
  \item \texttt{src/\allowbreak{}codi\_\allowbreak{}principal/\allowbreak{}nodes/\allowbreak{}location/\allowbreak{}motor\_\allowbreak{}reader}
  \item \texttt{src/\allowbreak{}codi\_\allowbreak{}principal/\allowbreak{}nodes/\allowbreak{}location/\allowbreak{}imu/\allowbreak{}imu\_\allowbreak{}reader}
\end{itemize}

Que s'encarreguen de llegir les dades de la IMU i de l'\emph{encoder} del motor perquè es puguin utilitzar a la resta del sistema.

i el \emph{node} principal:
\nopagebreak

\begin{itemize}
  \item \texttt{src/\allowbreak{}codi\_\allowbreak{}principal/\allowbreak{}nodes/\allowbreak{}location/\allowbreak{}bicycle\_\allowbreak{}model/\allowbreak{}bicycle\_\allowbreak{}model}
\end{itemize}

Que s'encarrega d'utilitzar les lectures per calcular la posició del cotxe en tot moment.

\subsection{Bicycle Model}\label{sec:bicycle-model}

L'objectiu d'aquest \emph{node} és localitzar el cotxe, és a dir, calcular la seva posició (x,y) i la seva orientació al llarg del temps.

Per fer aquest càlcul, primer cal conèixer la velocitat del cotxe, que s'obté combinant les lectures de l'\emph{encoder} i de la IMU mitjançant un filtre complementari:
\nopagebreak

\begin{equation*}
  v = \alpha\,(v + a\,\Delta t) + (1-\alpha)\,v_{\text{encoder}}
\end{equation*}

On $\alpha$ és un valor entre 0 i 1 que indica quant es confia en l’acceleròmetre respecte a l’\emph{encoder}. L’acceleròmetre de la IMU detecta ràpidament els canvis de velocitat, mentre que l’\emph{encoder} evita que l’error que es comet en integrar l’acceleració s’acumuli amb el temps. A més, quan l’\emph{encoder} indica que les rodes estan aturades, la velocitat es considera zero, perquè el petit error de l’acceleròmetre no faci avançar el cotxe quan està quiet.

Utilitzant aquesta velocitat i l'angle de les rodes, el \emph{node} pot calcular com varia l'orientació del cotxe i, a partir d'aquesta, el seu desplaçament en els eixos x i y. Per fer-ho utilitza l'algoritme Bicycle Model, anomenat així perquè permet simplificar el moviment d'un cotxe representant-lo com si fos una bicicleta.

Aquest model considera que el moviment del vehicle depèn principalment de la velocitat, de l'angle de les rodes i de la distància entre els eixos. A partir d'aquests paràmetres es pot calcular el radi de gir mitjançant:
\nopagebreak

\begin{equation*}
  R = \frac{L}{\tan\delta}
\end{equation*}

On:
\nopagebreak

\begin{itemize}
  \item $R$ = radi de gir.
  \item $L$ = distància entre l'eix davanter i l'eix posterior.
  \item δ = angle de les rodes respecte de l'eix longitudinal del cotxe.
\end{itemize}

Un cop conegut el radi de gir, es pot calcular la velocitat angular del cotxe:
\nopagebreak

\begin{equation*}
  \omega = \frac{v}{R}
\end{equation*}

I, substituint el radi de gir:
\nopagebreak

\begin{equation*}
  \omega = \frac{v}{L}\,\tan\delta
\end{equation*}

% Fins aquí cap a la pàgina anterior (les fórmules no es poden separar del text)
\pagebreak

El temps transcorregut entre dues actualitzacions també es té en compte, de manera que en cada iteració es calcula una nova posició:
\nopagebreak

\begin{align*}
  x_{\text{nova}} &= x + v\cos\theta\,\Delta t \\
  y_{\text{nova}} &= y + v\sin\theta\,\Delta t
\end{align*}

I una nova orientació:
\nopagebreak

\begin{equation*}
  \theta_{\text{nova}} = \theta + \frac{v}{L}\,\tan\delta\,\Delta t
\end{equation*}

Així, el \emph{node} estima contínuament la posició i l'orientació del cotxe a partir del seu moviment.

\begin{figure}[H]
  \centering
  
  \caption[{\protect\hyperref[imatge-12]{Dibuix orientatiu del Bicycle Model}\protect\newline \textit{Feta amb IA (Claude)}}]{Dibuix orientatiu del Bicycle Model}\label{imatge-12}
\end{figure}

\section{MAPATGE}

Aquest bloc construeix el mapa del circuit a partir de les dades de localització del cotxe, prèviament processades, i de les dades obtingudes mitjançant el LiDAR.

El codi encarregat de llegir el LiDAR es troba a \texttt{src/\allowbreak{}lidar\_\allowbreak{}drivers} i no ha estat desenvolupat pel programador del grup. Es tracta del codi recomanat pel fabricant d’acord amb les especificacions del sensor (\emph{datasheet}). Aquest codi publica, després de cada volta completa del LiDAR, les dades de lectura en forma de coordenades polars (distància i angle) al \emph{topic} \texttt{/\allowbreak{}ldlidar\_\allowbreak{}node/\allowbreak{}scan}, amb missatges de tipus \texttt{LaserScan}.

Els \emph{nodes} que formen el bloc de mapatge són:
\nopagebreak

\begin{itemize}
  \item \texttt{src/\allowbreak{}codi\_\allowbreak{}principal/\allowbreak{}nodes/\allowbreak{}mapping/\allowbreak{}lidar/\allowbreak{}lidar\_\allowbreak{}image\_\allowbreak{}creator}
  \item \texttt{src/\allowbreak{}codi\_\allowbreak{}principal/\allowbreak{}nodes/\allowbreak{}mapping/\allowbreak{}lidar/\allowbreak{}lidar\_\allowbreak{}processing}
\end{itemize}

Primer de tot, cal definir què són les coordenades locals i globals per tal d’entendre tot el que s’explica a continuació.

Les coordenades locals són les que tenen com a referència el mateix cotxe. El seu origen és el LiDAR, l’eix x apunta cap a la part davantera del cotxe i l’eix y cap a l’esquerra. Les dades que llegeix el LiDAR estan en aquestes coordenades, i per això canvien quan el cotxe es mou: un mateix con, que no es mou del circuit, té unes coordenades locals diferents cada vegada que el cotxe canvia de posició o d’orientació.

Les coordenades globals, en canvi, tenen com a referència un punt fix del circuit, que és la posició on comença el cotxe. Així, cada con té sempre les mateixes coordenades globals, independentment d’on es trobi el cotxe. Aquestes són les coordenades que s’utilitzen per localitzar el cotxe i per construir el mapa.

\subsection{lidar\_image\_creator}

Aquest \emph{node} està subscrit al \emph{topic} \texttt{/\allowbreak{}ldlidar\_\allowbreak{}node/\allowbreak{}scan} i s’encarrega de processar les dades obtingudes del LiDAR. Les seves funcions principals són eliminar lectures errònies, convertir les coordenades polars a coordenades cartesianes, transformar les coordenades locals a coordenades globals i corregir la distorsió provocada pel moviment del cotxe durant l’escaneig.

La conversió de coordenades polars a cartesianes es realitza mitjançant raons trigonomètriques. A partir de la distància i l’angle de cada punt, es calculen les seves coordenades X i Y. Posteriorment, les coordenades locals es transformen en coordenades globals tenint en compte la posició i l’orientació del cotxe. D’aquesta manera, els punts detectats pel LiDAR es poden situar correctament dins del mapa global.

La tasca més complexa és corregir la distorsió provocada pel moviment del cotxe durant el temps que el LiDAR necessita per completar una lectura. Com que el LiDAR publica les dades en completar una volta, el primer punt de la lectura tindrà un error equivalent al desplaçament del cotxe durant la lectura, i aquest error anirà disminuint fins a l’últim punt, que té un error zero. Per solucionar-ho, el codi estima la posició del cotxe en el moment en què es va capturar cada punt. Per fer-ho, utilitza la mateixa fórmula emprada per calcular la posició del cotxe i estima quant s’ha desplaçat i rotat entre la captura de cada punt i el moment actual. El temps entre punts es calcula a partir del temps necessari per rebre les diferents lectures i es distribueix entre els punts de l’escaneig. D’aquesta manera, es pot compensar el moviment del cotxe i obtenir una representació dels punts molt més fidel a la seva posició real.

\begin{figure}[H]
  \centering
  
  \caption[{\protect\hyperref[imatge-13]{Distorsió de la lectura del LiDAR pel moviment del cotxe}\protect\newline \textit{Feta amb IA (Claude)}}]{Distorsió de la lectura del LiDAR pel moviment del cotxe}\label{imatge-13}
\end{figure}

\subsection{lidar\_processing}

Aquest \emph{node} està subscrit al \emph{topic} \texttt{scan\_\allowbreak{}xy} i té com a objectius detectar els cons i incorporar-los al mapa global.

La detecció dels cons es realitza mitjançant un algoritme de \emph{clustering}, que té com a objectiu agrupar punts que es troben prou a prop els uns dels altres. Per entendre el funcionament de l’algoritme, suposem que \texttt{scan\_\allowbreak{}xy} ha detectat els punts A, B, C i D. Primer, l’algoritme crea una matriu anomenada \texttt{cluster} i hi afegeix el punt A. A continuació, compara la distància entre A i B mitjançant el teorema de Pitàgores. Si la distància és inferior a un valor llindar preestablert, anomenat \emph{threshold}, es considera que els dos punts pertanyen al mateix grup. En aquest cas, es calcula la mitjana ponderada de les seves coordenades i s’utilitza aquest valor com a representació del grup. Si la distància és superior al \emph{threshold}, el punt B es considera un punt diferent i s’afegeix a la matriu \texttt{cluster}. A continuació, el punt C es compara amb els grups existents i es repeteix el mateix procés. Aquest procediment continua fins que s’han processat tots els punts de \texttt{scan\_\allowbreak{}xy}. Per evitar considerar com a cons els grups formats per punts aïllats o per lectures errònies, s’utilitza un comptador de punts. Aquest comptador registra quants punts formen part de cada grup. Si un grup no arriba a un mínim de 3 punts, es descarta. Com a resultat, s’obté una matriu que conté únicament els cons detectats durant una volta del LiDAR. Aquesta matriu és temporal i es torna a generar cada vegada que el LiDAR completa una nova volta.

La creació del mapa global utilitza un algoritme similar al de la detecció de cons. La principal diferència és que, en aquest cas, la matriu a la qual s’aplica l’algoritme és la resultant del \emph{clustering} anterior, és a dir, la matriu \texttt{cluster} amb els cons detectats en l’escaneig actual. A més, el resultat, que és el mapa, es conserva cada vegada que s’executa l’algoritme, en lloc de tornar-se a generar a cada volta del LiDAR. Quan es detecta un con que ja forma part del mapa, la seva posició s’actualitza a partir de la nova mesura. D’aquesta manera, les diferents deteccions del mateix con es poden combinar i reduir l’error de la seva posició. Per tant, a mesura que el cotxe realitza més voltes i obté noves mesures, el mapa es va actualitzant i les posicions dels cons es poden determinar amb més precisió.

\subsection{Integració de la localització}\label{sec:integracio-localitzacio}

El procés de localització té un problema d’acumulació d’error. Per solucionar-ho, es va optar per utilitzar també el LiDAR per localitzar el cotxe. Aquesta correcció també es calcula dins del \emph{node} \texttt{lidar\_\allowbreak{}processing}, en lloc de fer-se en un \emph{node} independent.

Això es deu al fet que la informació necessària per actualitzar la posició dels cons és principalment la diferència entre les posicions obtingudes en les diferents deteccions. El programa calcula aquestes diferències, en determina la mitjana i l’aplica a la posició actual del cotxe.

D’aquesta manera, no és necessari crear un \emph{node} addicional que realitzi aquest càlcul. Això permet reduir la quantitat de processos que s’executen simultàniament i, per tant, disminuir la càrrega de la CPU.

\section{PLANIFICACIÓ DE LA TRAJECTÒRIA}

L’objectiu d’aquest bloc és utilitzar el mapa de cons per crear una traçada que el vehicle pugui seguir. L’algoritme utilitzat està basat en el desenvolupat per l’equip de Formula Student FaSTTUBe (Formula Student Team TU Berlin). Ha resultat especialment pràctic per al nostre projecte, ja que les competicions de Formula Student inclouen proves de conducció autònoma i aquest equip també utilitza un LiDAR per obtenir informació del circuit.

A causa de la seva complexitat, el codi d’aquest bloc no ha estat desenvolupat directament pel programador del grup. Per aquest motiu, en aquest apartat se’n farà una explicació breu i simplificada.

L’algoritme es divideix en dues fases principals:
\nopagebreak

\subsection{Separació dels cons}

En primer lloc, l’algoritme analitza el mapa i intenta determinar quins cons corresponen a la banda esquerra del circuit i quins corresponen a la banda dreta. Això ho fa mitjançant un algoritme que calcula l’angle entre dos cons i, si no és gaire tancat, els situa a la mateixa banda del circuit.

Aquesta separació és necessària perquè posteriorment l’algoritme pugui determinar l’espai que hi ha entre les dues bandes del circuit.

\subsection{Generació de la trajectòria}

L’algoritme genera triangles entre punts de les dues bandes del circuit, els triangles resultants tindran dos vèrtexs que coincidiran amb punts d’una banda i un tercer amb un punt de l’altra banda. L’algoritme llavors buscarà el punt mitjà dels dos costats que inclouen el tercer con. Finalment, es generen punts addicionals entre els punts obtinguts per reduir la distància entre ells i aconseguir una trajectòria més contínua i adequada per al seguiment del vehicle.

\begin{figure}[H]
  \centering
  
  \caption[{\protect\hyperref[imatge-14]{Simulació del path plan en una recta}\protect\newline \textit{Captura d'una simulació del path plan}}]{Simulació del path plan en una recta}\label{imatge-14}
\end{figure}

\subsection{Bridge}

Per poder utilitzar aquest algoritme dins del projecte s’han creat un \emph{node} i un mòdul auxiliar:
\nopagebreak

\begin{itemize}
  \item \texttt{src/\allowbreak{}codi\_\allowbreak{}principal/\allowbreak{}nodes/\allowbreak{}path\_\allowbreak{}planning/\allowbreak{}path\_\allowbreak{}planner\_\allowbreak{}bridge\_\allowbreak{}node.py}
  \item \texttt{src/\allowbreak{}codi\_\allowbreak{}principal/\allowbreak{}nodes/\allowbreak{}path\_\allowbreak{}planning/\allowbreak{}bridge\_\allowbreak{}utils.py}
\end{itemize}

El \emph{node} \texttt{path\_\allowbreak{}planner\_\allowbreak{}bridge\_\allowbreak{}node.py} actua com a pont entre el nostre sistema i l’algoritme de planificació de la trajectòria, gestionant-ne la comunicació i fent possible la seva integració amb la resta del projecte. El mòdul \texttt{bridge\_\allowbreak{}utils.py} no és un \emph{node}, sinó un conjunt de funcions auxiliars que el \emph{node} utilitza per convertir el mapa de cons al format que necessita l’algoritme.

\section{CONTROL}

Finalment, tenim el sistema de control, que té la tasca de controlar i conduir el cotxe. Aquest sistema s'encarrega principalment del control de la velocitat i del control de la direcció.

\subsection{Control de velocitat}

El control de velocitat es realitza mitjançant un PID (Proporcional, Integral i Derivatiu). Es tracta d'un algoritme de control que té com a objectiu mantenir una variable en un valor desitjat, també anomenat \emph{setpoint}. En aquest cas, la variable controlada és la velocitat del cotxe, mentre que el valor objectiu serà una velocitat determinada.

El PID calcula contínuament la diferència entre la velocitat objectiu i la velocitat real mesurada. A partir d'aquest error, calcula la correcció que s'ha d'aplicar utilitzant tres components:
\nopagebreak

\begin{itemize}
  \item \textbf{Proporcional (P):} reacciona a l'error actual. Com més gran sigui l'error, més gran serà la correcció aplicada.
  \item \textbf{Integral (I):} acumula els errors produïts al llarg del temps. Serveix per corregir errors persistents que el component proporcional, per si sol, no és capaç d'eliminar.
  \item \textbf{Derivatiu (D):} analitza com està canviant l'error i permet anticipar-ne l'evolució. Això ajuda a reduir les oscil·lacions i evita que el sistema sobrepassi excessivament el valor objectiu.
\end{itemize}

La correcció que s’aplica als motors és la suma dels tres components:
\nopagebreak

\begin{equation*}
  \text{correcció} = K_p\,e + K_i\int e\,dt + K_d\,\frac{de}{dt}
\end{equation*}

En el nostre cotxe, els valors utilitzats són $K_p = 0{,}8$, $K_i = 0{,}02$ i $K_d = 0{,}1$, la velocitat objectiu és de 0,5 m/s i el càlcul es repeteix cada 0,1 s.

\begin{figure}[H]
  \centering
  
  \caption[{\protect\hyperref[imatge-15]{Explicació PID}\protect\newline \textit{Font:} \protect\url{https://commons.wikimedia.org/wiki/File:PID_en.svg}}]{Explicació PID}\label{imatge-15}
\end{figure}

D'aquest control de velocitat se n'encarrega el \emph{node}:
\nopagebreak

\begin{itemize}
  \item \texttt{src/\allowbreak{}codi\_\allowbreak{}principal/\allowbreak{}nodes/\allowbreak{}control/\allowbreak{}speed\_\allowbreak{}control}
\end{itemize}

\subsection{Control de la direcció}

Per controlar la direcció del cotxe s'utilitzen dos sistemes diferents: un sistema principal encarregat de seguir la trajectòria calculada i un sistema de seguretat que serà utilitzat en cas que, en provar el cotxe, el sistema principal no funcioni, per tal que el dia de la presentació hi hagi un mínim que permeti ensenyar el funcionament de la resta del cotxe.

\subsubsection{Seguiment de la trajectòria}

El sistema principal de control de la direcció es troba al \emph{node}:
\nopagebreak

\begin{itemize}
  \item \texttt{src/\allowbreak{}codi\_\allowbreak{}principal/\allowbreak{}nodes/\allowbreak{}control/\allowbreak{}path\_\allowbreak{}follower}
\end{itemize}

L'algoritme utilitzat és el Pure Pursuit. El seu funcionament consisteix a crear un cercle imaginari al voltant del cotxe amb un radi determinat, conegut com a \emph{lookahead distance}. A continuació, busca un punt de la trajectòria o \emph{path plan} que es trobi sobre el perímetre d'aquest cercle.

\begin{figure}[H]
  \centering
  
  \caption[{\protect\hyperref[imatge-16]{Funcionament del Pure Pursuit}\protect\newline \textit{Font:} \protect\url{https://vinesmsuic.github.io/robotics-purepersuit/}}]{Funcionament del Pure Pursuit}\label{imatge-16}
\end{figure}

Un cop seleccionat aquest punt, l'algoritme calcula quin ha de ser el radi de gir del cotxe perquè aquest pugui arribar al punt seleccionat. A partir d'aquest radi de gir es calcula l'angle de direcció necessari.

Concretament, si $\alpha$ és l’angle entre la direcció del cotxe i el punt seleccionat, $l_d$ és la distància fins a aquest punt i $L$ és la distància entre eixos, el radi de gir necessari per arribar al punt és:
\nopagebreak

\begin{equation*}
  R = \frac{l_d}{2\sin\alpha}
\end{equation*}

Substituint aquest radi a la fórmula $R = L/\tan\delta$ del Bicycle Model (apartat \ref{sec:bicycle-model}), s’obté l’angle de direcció:
\nopagebreak

\begin{equation*}
  \delta = \arctan\left(\frac{2L\sin\alpha}{l_d}\right)
\end{equation*}

En el nostre cotxe s’utilitza una \emph{lookahead distance} de 0,2 m, i l’angle resultant es limita a l’angle màxim que permet el sistema de direcció.

Aquest algoritme resulta especialment útil perquè no reacciona únicament a la posició actual del vehicle, sinó que té en compte un punt situat més endavant en la trajectòria. D'aquesta manera, el cotxe pot anticipar-se als girs que haurà de realitzar.

\subsubsection{Sistema de seguretat}

El segon sistema de control es troba al \emph{node}:
\nopagebreak

\begin{itemize}
  \item \texttt{src/\allowbreak{}codi\_\allowbreak{}principal/\allowbreak{}nodes/\allowbreak{}control/\allowbreak{}proximity\_\allowbreak{}sensors}
\end{itemize}

Aquest sistema utilitza els dos sensors de proximitat del cotxe per detectar la presència de parets o obstacles propers.

Utilitzant un altre controlador PID, anteriorment explicat, el sistema modifica la direcció del vehicle amb l'objectiu d'evitar una col·lisió. Es tracta d'un algoritme relativament simple, però pot evitar que el cotxe xoqui.

\subsection{Comunicació amb el servomotor}

Finalment, el \emph{node}:
\nopagebreak

\begin{itemize}
  \item \texttt{src/\allowbreak{}codi\_\allowbreak{}principal/\allowbreak{}nodes/\allowbreak{}control/\allowbreak{}steering}
\end{itemize}

És l'encarregat de comunicar-se directament amb el servomotor de direcció. Aquest \emph{node} transforma l'angle de direcció calculat pels diferents sistemes de control en una ordre adequada per al servomotor, cosa que permet moure físicament les rodes fins a la posició necessària.

\section{ORGANITZACIÓ GLOBAL}\label{sec:organitzacio-global}

En el següent esquema (\hyperref[annex-2]{Annex 2}) es mostra l’organització del sistema. Com es pot veure a la llegenda, els diferents elements es representen mitjançant formes i colors segons la seva funció.

\subsection{Llegenda}

Les formes rodones representen els \emph{nodes}, i els rombes, els \emph{topics} o les lectures dels sensors. Alguns \emph{topics} no estan representats explícitament perquè no són importants per entendre el funcionament general del sistema; en aquests casos, simplement es mostra la fletxa i es dona per fet que existeix un \emph{topic} entre els elements.

Alguns \emph{topics}, com \texttt{location\_\allowbreak{}solved} i \texttt{steering\_\allowbreak{}angle}, apareixen dues vegades al diagrama, i una d’elles porta l’etiqueta \texttt{t-1}. Aquesta etiqueta indica que el \emph{node} que els rep no utilitza el valor que s’està calculant en aquell moment, sinó el que es va publicar a la iteració anterior (l’instant t-1).

Les fletxes també es diferencien segons el tipus de comunicació:
\nopagebreak

\begin{itemize}
  \item Les línies contínues indiquen que el \emph{topic} activa el \emph{node}, però la informació que conté el \emph{topic} no és utilitzada pel \emph{node}.
  \item Les línies discontínues indiquen que el \emph{topic} transmet informació al \emph{node}, però no activa el \emph{node}.
  \item Les línies de guions i punts indiquen que el \emph{topic} activa el \emph{node} i, al mateix temps, li transmet informació.
\end{itemize}

Finalment, els colors indiquen a quin bloc del codi pertany cada element. El color verd correspon al bloc de localització, el lila al bloc de mapatge, el groc al bloc de \emph{path plan} i el vermell al bloc de control.

\subsection{Explicació}

Com es pot veure, el funcionament del codi comença amb la lectura del LiDAR (LaserScan). Aquesta lectura activa els \emph{nodes} encarregats de llegir la velocitat i altres dades necessàries per poder localitzar el cotxe.

Un cop finalitzada la localització, s’activen els algoritmes de mapatge. D’aquesta manera, com que per realitzar la localització és necessari disposar de les dades del LaserScan, i el processament de la localització triga més temps que el processament necessari perquè el LaserScan arribi a \texttt{lidar\_\allowbreak{}image\_\allowbreak{}creator}, els \emph{nodes} de mapatge no poden començar a treballar fins que no disposen de totes les dades necessàries.

Seguidament, \texttt{lidar\_\allowbreak{}processing} calcula la nova localització del cotxe i la transmet a \texttt{bicycle\_\allowbreak{}model}. D’aquesta manera, el LaserScan actua com una mena de rellotge del sistema, ja que marca el ritme d’actualització i assegura que, en cada iteració, es treballi amb les dades més actuals disponibles.

Finalment, a partir del mapa actualitzat es calcula el \emph{path plan} i, amb aquest, es fa el control del cotxe. Aquests \emph{nodes} segueixen la mateixa norma: cada \emph{node} s’activa quan rep la dada que triga més a arribar, de manera que sempre treballa amb la informació més recent.

\section{SIMULACIÓ I LAUNCHERS}

\subsection{Simulació}

Per poder provar el codi sense haver d'utilitzar el cotxe real, s'ha creat un simulador, que es troba al paquet \texttt{src/\allowbreak{}car\_\allowbreak{}simulator}.

El simulador recrea dues coses: el moviment del cotxe i la lectura del LiDAR. Per una banda, calcula com es mou el cotxe a partir de l'angle de direcció i la velocitat que li envia el codi de control, utilitzant el mateix Bicycle Model explicat a l'apartat \ref{sec:bicycle-model}. Per l'altra, a partir de la posició del cotxe i d'un mapa amb la posició dels cons, genera les mateixes dades que enviaria el LiDAR real.

D'aquesta manera, la resta del sistema (mapatge, \emph{path plan} i control) és exactament el mateix codi que s'executa al cotxe, i el resultat es pot veure a RViz2.

\begin{figure}[H]
  \centering
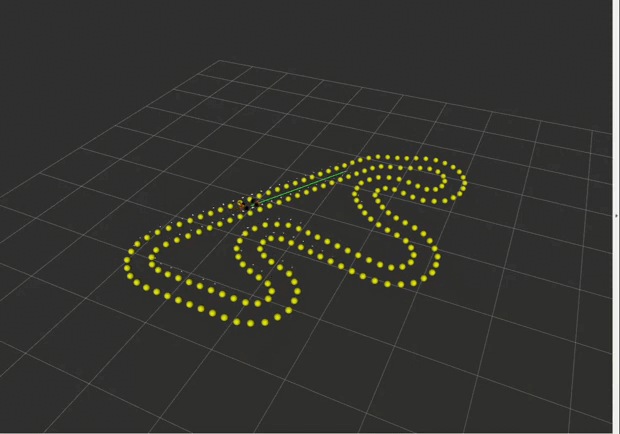
[picture p15: imatges/imatge_12_simulacio_rviz.png]
  
  \caption[{\protect\hyperref[imatge-17]{Simulació del cotxe a RViz2}\protect\newline \textit{Captura de la simulació a RViz2}}]{Simulació del cotxe a RViz2}\label{imatge-17}
\end{figure}

Per executar la simulació s'utilitza la comanda:
\nopagebreak

\begin{lstlisting}[language=bash]
ros2 launch my_pakage simulation_full.launch.py track:=bcn
\end{lstlisting}

El paràmetre \texttt{track} permet escollir el circuit (\texttt{bcn} o \texttt{realista}).

\subsection{Launchers}

Com que el projecte està format per molts \emph{nodes} que s'han d'executar alhora, s'utilitzen \emph{launchers}, que són fitxers que inicien tots els \emph{nodes} necessaris amb una sola comanda. Es troben a \texttt{src/\allowbreak{}codi\_\allowbreak{}principal/\allowbreak{}launch}.

El \emph{launcher} principal és \texttt{full\_\allowbreak{}car.launch.py}, que és el que s'utilitza al cotxe real. Inicia tots els \emph{nodes} del sistema: el \emph{driver} del LiDAR, la lectura de l'\emph{encoder} i la IMU, la localització, el mapatge, el \emph{path plan}, el control de velocitat i la direcció. A més, tots els paràmetres físics del cotxe es troben definits al principi d'aquest fitxer, de manera que si es canvia alguna peça només cal modificar-los en un sol lloc.

Per executar-lo s'utilitza la comanda:
\nopagebreak

\begin{lstlisting}[language=bash]
ros2 launch my_pakage full_car.launch.py
\end{lstlisting}

\section{VERSIONS}

Durant el procés de programació, hem utilitzat Git, una eina de control de versions que permet gestionar els canvis del codi al llarg del desenvolupament del projecte. Entre les seves principals funcionalitats destaquen la possibilitat de recuperar versions anteriors, crear ramificacions (\emph{branches}) per desenvolupar i provar noves funcionalitats de manera independent i publicar el codi en un repositori remot per poder-hi accedir des de diferents ordinadors.

Gràcies a aquesta eina, hem pogut mantenir un registre dels canvis i organitzar el desenvolupament del programari. En total, s’han registrat 87 versions del codi (75 a la branca principal), de les quals 22 corresponien a versions considerades potencialment definitives. A més, s’han creat 11 ramificacions per desenvolupar i provar funcionalitats noves. La majoria s’han acabat incorporant al projecte principal, però algunes s’han hagut de descartar, ja que les proves realitzades no han donat els resultats esperats.

\bloc{CONCLUSIONS}

\section{INCIDÈNCIES}

Durant les proves del vehicle s’han produït dos incidents elèctrics.

El primer va ser l’explosió del controlador de motors DRV8833. Les causes possibles identificades van ser un curtcircuit provocat per un error de connexió o una sobrealimentació, i es van estudiar totes dues hipòtesis i es van prendre mesures. Malgrat haver comptat amb l’assessorament de diversos enginyers de telecomunicacions, no s’ha pogut determinar amb certesa l’origen de l’avaria.

El segon incident va consistir en el sobreescalfament de dos cables, que va provocar la deformació del seu aïllament de plàstic. En aquest cas, la causa identificada va ser un curtcircuit durant una de les proves.

Aquests incidents han posat de manifest la importància de verificar les connexions elèctriques, comprovar els límits de funcionament dels components i adoptar mesures de seguretat abans de realitzar les proves del sistema.

\section{RESULTATS}

En conjunt, el cotxe ha assolit resultats satisfactoris en la majoria dels àmbits del projecte.

Pel que fa a la part electrònica, un cop resolts els incidents descrits a l’apartat 22, el sistema d’alimentació ha funcionat correctament i tots els components reben una alimentació estable. Quant a les connexions, la Raspberry Pi es comunica correctament tant amb els sensors com amb els actuadors.

En l’àmbit mecànic, l’estructura ha demostrat ser prou resistent per suportar el pes del vehicle i el diferencial compleix adequadament la seva funció. La direcció, tot i no ser la solució òptima, permet assolir els objectius plantejats.

Pel que fa al programari, el codi ha funcionat segons el previst: en l’entorn de simulació, que reprodueix condicions realistes, el vehicle ha estat capaç de completar els circuits simulats.

No obstant això, alguns aspectes no han assolit el rendiment esperat. Els motors i el servomotor presenten un parell lleugerament insuficient, i el joc excessiu de les rodes provoca imprecisions en el desplaçament. A més, malgrat els esforços per mantenir un cablejat ordenat, els cables han acabat entrellaçats, fet que dificulta la identificació de cada connexió.

\section{CONCLUSIONS}

En conclusió, aquest projecte ha estat més ambiciós del que, com a estudiants de batxillerat, érem capaços d’assumir, i hi ha diversos àmbits que han quedat amb una qualitat inferior a la que esperàvem. També hi ha influït el factor econòmic, que ens ha obligat a comprar components de pitjor qualitat o, directament, a fabricar-ne alguns nosaltres mateixos, com els cons.

Més enllà del resultat, el fet que el projecte fos més gran del que podíem assumir ens ha obligat a formar-nos en eines i àmbits molt diversos, com ROS 2, Git i GitHub, Fusion 360 i el disseny 3D, l’electrònica i la robòtica. Aquest és un aprenentatge que ens acompanyarà tota la vida.

\section{AGRAÏMENTS}

Voldríem agrair la col·laboració de l’Institut Escola Industrial, del nostre tutor, Josep Maria Bergadà i dels nostres amics i familiars, David Rodríguez, Adrià Simó i Carles Simó, que ens han proporcionat tota l’ajuda i el material que ens ha fet falta al llarg del treball. També volem agrair a papalotis el codi de planificació de la trajectòria que ha publicat, en què s’ha basat aquesta part del projecte.

\addtocontents{toc}{\protect\addvspace{1.5em}}
\clearpage
\phantomsection
\addcontentsline{toc}{section}{ANNEXOS}
\section*{ANNEXOS}

\phantomsection
\addcontentsline{toc}{subsection}{Annex 1: Codi exemple d'un node de ROS 2}
\subsection*{Annex 1: Codi exemple d'un node de ROS 2}\label{annex-1}

\begin{lstlisting}[language=Python]
import rclpy
from rclpy.node import Node
from std_msgs.msg import String

class MyNode(Node):

    def __init__(self):
        super().__init__('my_node')

        self.subscription = self.create_subscription(
            String,
            'my_topic',
            self.listener_callback,
            10
        )
        self.publisher = self.create_publisher(
            String,
            'my_topic',
            10
        )

    def listener_callback(self, msg):
        print('Missatge rebut:', msg.data)

def main(args=None):
    rclpy.init(args=args)

    node = MyNode()
    rclpy.spin(node)
    node.destroy_node()
    rclpy.shutdown()

if __name__ == '__main__':
    main()
\end{lstlisting}

\begin{landscape}
\phantomsection
\addcontentsline{toc}{subsection}{Annex 2: Mapa conceptual del sistema}
\subsection*{Annex 2: Mapa conceptual del sistema}\label{annex-2}

\begin{figure}[H]
  \centering
  
  \caption[{\protect\hyperref[imatge-18]{Mapa conceptual de l'organització del sistema}\protect\newline \textit{Feta amb Lucid}}]{Mapa conceptual de l'organització del sistema}\label{imatge-18}
\end{figure}
\end{landscape}

\begin{landscape}
\phantomsection
\addcontentsline{toc}{subsection}{Annex 3: Esquema de connexions del cotxe}
\subsection*{Annex 3: Esquema de connexions del cotxe}\label{annex-3}

\begin{figure}[H]
  \centering
  
  \caption[{\protect\hyperref[imatge-19]{Esquema de connexions del cotxe}\protect\newline \textit{Feta amb IA (Claude)}}]{Esquema de connexions del cotxe}\label{imatge-19}
\end{figure}
\end{landscape}

\clearpage
\phantomsection
\addcontentsline{toc}{section}{ÍNDEX D'IMATGES}
{\setlength{\parskip}{0pt}\hypersetup{linktoc=page}\listoffigures}

% L'índex de taules va a la mateixa pàgina que el d'imatges (sense \clearpage)
\vspace{2em}
\phantomsection
\addcontentsline{toc}{section}{ÍNDEX DE TAULES}
{\setlength{\parskip}{0pt}\let\section\origsection\listoftables}

% Bibliografia en format APA: ordre alfabètic, sense numerar i amb sagnat francès
\clearpage
\phantomsection
\addcontentsline{toc}{section}{BIBLIOGRAFIA}
\origsection*{BIBLIOGRAFIA}

{\setlength{\parskip}{0.6\baselineskip}\raggedright
\everypar{\hangindent=1.27cm\hangafter=1}

Asaro, P. (2010). \emph{Interview with Ernst Dickmanns} [Entrevista]. Robotics History Project, IEEE Robotics and Automation Society. \url{https://roboticshistory.ieee-ras.org/interview/interview-with-ernst-dickmanns-53/}

Bel Geddes, N. (1940). \emph{Magic motorways}. Random House. \url{https://archive.org/details/magicmotorways00geddrich/page/240/mode/2up}

Defense Advanced Research Projects Agency. (s. d.). \emph{The Grand Challenge}. \url{https://www.darpa.mil/about/innovation-timeline/grand-challenge}

Dirección General de Tráfico. (2025, 30 d’octubre). \emph{Vehículos automatizados}. \url{https://www.dgt.es/muevete-con-seguridad/vehiculos-seguros/conduccion-automatizada/vehiculos-de-conduccion-automatizada/}

Hobbywing. (s. d.). \emph{UBEC 5A} [Fitxa tècnica]. \url{https://www.hobbywing.com/en/products/ubec-5a93}

LDROBOT. (2023). \emph{LiDAR sensor STL-19P datasheet} (v1.0) [Fitxa tècnica]. Waveshare. \url{https://files.waveshare.com/wiki/D500-LiDAR-Kit/LDROBOT_STL-19P_Datasheet_EN_v1.0(1).pdf}

\emph{Motor GA12-N20 amb encoder} [Fitxa tècnica]. (s. d.). Scribd. \url{https://es.scribd.com/document/388716290/GA12-N20}

National Geographic Historia. (s. d.). \emph{Pasado, presente y futuro de la conducción autónoma}. \url{https://historia.nationalgeographic.com.es/promociones/pasado-presente-futuro-conduccion-autonoma_12014}

No te lo imaginabas: este fue el primer vehículo autónomo y es de 1986. (2018, 29 de juliol). \emph{TN}. \url{https://tn.com.ar/autos/novedades/2018/07/29/no-te-lo-imaginabas-este-fue-el-primer-vehiculo-autonomo-y-es-de-1986/}

Open Robotics. (s. d.). \emph{ROS 2 documentation: Jazzy}. \url{https://docs.ros.org/en/jazzy/index.html}

OVONIC. (s. d.). [Pàgina oficial del fabricant de bateries LiPo]. \url{https://www.ovonicshop.com/}

papalotis. (s. d.). \emph{ft-fsd-path-planning} [Programari]. GitHub. \url{https://github.com/papalotis/ft-fsd-path-planning}

Raspberry Pi Ltd. (s. d.-a). \emph{Raspberry Pi 4 Model B} [Fitxa tècnica]. \url{https://pip-assets.raspberrypi.com/categories/545-raspberry-pi-4-model-b/documents/RP-008341-DS-1-raspberry-pi-4-datasheet.pdf}

Raspberry Pi Ltd. (s. d.-b). \emph{Raspberry Pi Sense HAT} [Fitxa tècnica]. \url{https://pip-assets.raspberrypi.com/categories/676-raspberry-pi-sense-hat/documents/RP-008384-DS-1-sense-hat-product-brief.pdf}

Science: Radio auto. (1925, 10 d’agost). \emph{Time}. \url{https://time.com/archive/6653944/science-radio-auto/}

\emph{Sensor d’ultrasons HC-SR04P} [Fitxa tècnica]. (s. d.). Sigmanortec. \url{https://sigmanortec.ro/en/ultrasonic-sensor-hc-sr-04p-3-55v}

Texas Instruments. (s. d.). \emph{DRV8833 dual H-bridge motor driver} [Fitxa tècnica]. \url{https://www.ti.com/lit/ds/symlink/drv8833.pdf}

Tower Pro. (s. d.). \emph{MG90S} [Fitxa tècnica]. \url{https://towerpro.com.tw/product/mg90s-3/}

Universität der Bundeswehr München. (2016). \emph{Research spotlights} (Edició 01). \url{https://athene-forschung.unibw.de/doc/148540/148540.pdf}

Waymo. (s. d.). \emph{About Waymo}. \url{https://waymo.com/about/}

}

\end{document}
