Efrieza7/Cotxe_autonom/src/car_simulator/meshes/gt3_cabin.stl

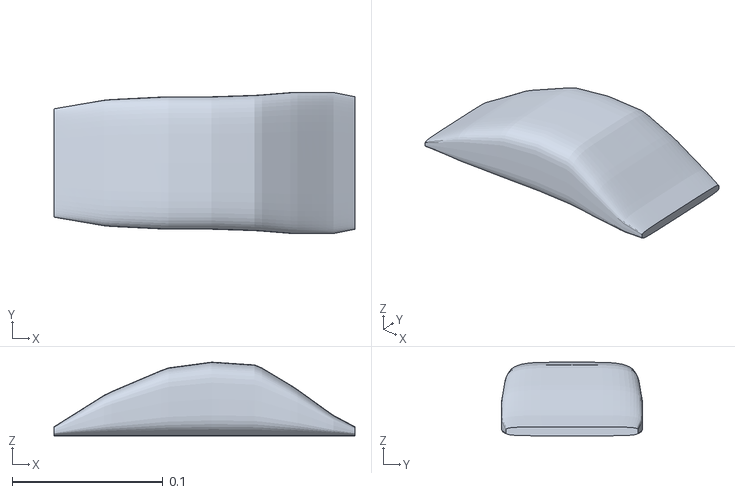
[picture p16: CAD file, 2026-09-24]
src/car_simulator/meshes/gt3_cabin.stl
0.2 x 0.094 x 0.049
