Efrieza7/Cotxe_autonom/src/lidar_drivers/ldlidar_node/urdf/model/LD19.stl

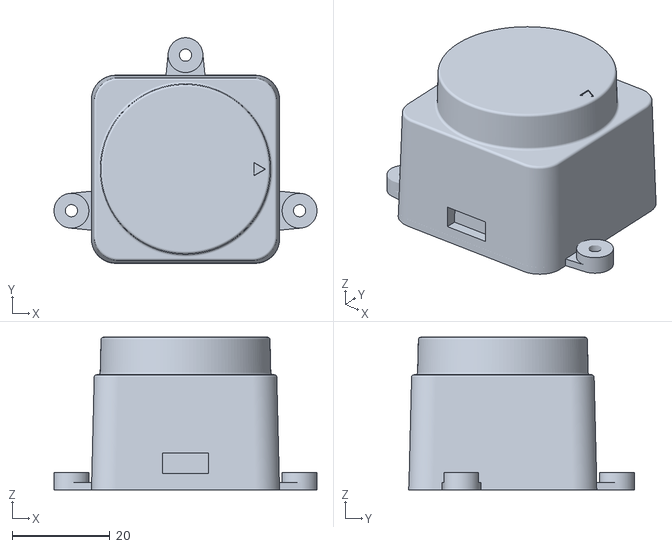
[picture p17: CAD file, 2026-08-18]
src/lidar_drivers/ldlidar_node/urdf/model/LD19.stl
54.0 x 46.3 x 31.3
