Efrieza7/Cotxe_autonom/src/car_simulator/meshes/gt3_body.stl

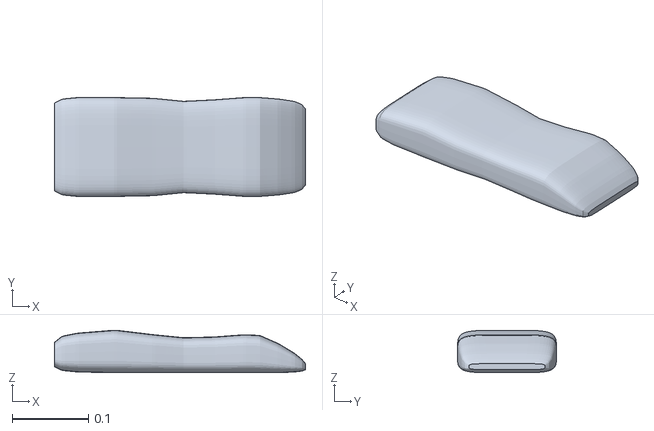
[picture p18: CAD file, 2026-09-24]
src/car_simulator/meshes/gt3_body.stl
0.33 x 0.13 x 0.0558
