Efrieza7/Cotxe_autonom/src/car_simulator/meshes/cone.stl

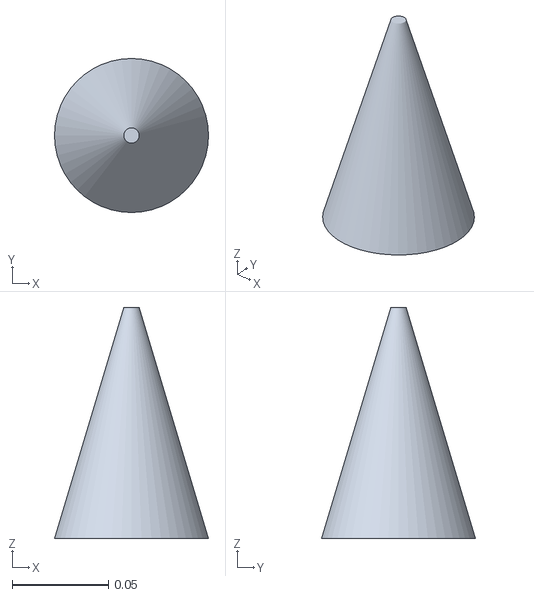
[picture p19: CAD file, 2026-09-24]
src/car_simulator/meshes/cone.stl
0.08 x 0.08 x 0.12
