Efrieza7/Cotxe_autonom/src/codi_principal/launch/simulation_full.launch.py

import math
import os

from ament_index_python.packages import get_package_share_directory
from launch import LaunchDescription
from launch.actions import DeclareLaunchArgument, IncludeLaunchDescription, OpaqueFunction
from launch.launch_description_sources import PythonLaunchDescriptionSource
from launch.substitutions import LaunchConfiguration
from launch_ros.actions import Node

# Angle màxim real de les rodes (rad): igual que full_car.launch.py,
# angle_rodes = asin(25.85 / 22 · sin(angle_servo)) amb el servo a 28.8 deg (~34.5 deg).
MAX_STEER = math.asin(25.85 / 22.0 * math.sin(math.radians(28.8)))


def generate_launch_description():
    """Full simulation stack: car_simulator + mapping + path planning + control.

    This is the launch to use for testing the car in simulation end-to-end:
        car_simulator (car_simulator_node, lidar_simulator_node,
                       cone_map_publisher_node, rviz2)
      + mapping (lidar_image_creator, lidar_processing, cone_map_viz)
      + path_planner_bridge + path_follower (drives the simulated car by
        publishing /target_angle and /target_speed, which car_simulator_node
        consumes)
    """

    return LaunchDescription([
        DeclareLaunchArgument('use_rviz', default_value='true'),
        DeclareLaunchArgument('track', default_value='bcn',
                              description='Circuit to load: ' + ', '.join(TRACKS)),
        OpaqueFunction(function=_launch_setup),
    ])


# Each track: map file in car_simulator/maps and a start pose (x, y, yaw) on its
# centreline, heading along the track. All maps are 0.35 m wide and their
# centreline has no curve tighter than 0.5 m radius (the car turns at ~0.26 m
# minimum); circuit_BCN was scaled x2.2 to get there.
TRACKS = {
    'bcn': ('circuit_BCN.yaml', '3.048', '1.731', '-2.132'),
    # circuit_BCN amb una sola vora (o per trams), per provar el camí amb una banda
    'bcn_fora': ('circuit_BCN_nomes_fora.yaml', '3.048', '1.731', '-2.132'),
    'bcn_dins': ('circuit_BCN_nomes_dins.yaml', '3.048', '1.731', '-2.132'),
    'bcn_trams': ('circuit_BCN_trams.yaml', '3.048', '1.731', '-2.132'),
    'realista': ('circuit_realista_35.yaml', '0.0', '0.0', '1.5596'),
}


def _launch_setup(context):
    # use_rviz = LaunchConfiguration('use_rviz')
    track = LaunchConfiguration('track').perform(context)
    if track not in TRACKS:
        raise RuntimeError(f"Unknown track '{track}'. Options: {', '.join(TRACKS)}")
    map_name, start_x, start_y, start_yaw = TRACKS[track]

    car_simulator_include = IncludeLaunchDescription(
        PythonLaunchDescriptionSource(
            os.path.join(
                get_package_share_directory('car_simulator'),
                'launch',
                'car_simulator.launch.py',
            )
        ),
        launch_arguments={
            #'use_rviz': use_rviz,
            'map_file': os.path.join(get_package_share_directory('car_simulator'), 'maps', map_name),
            'start_x': start_x,
            'start_y': start_y,
            'start_yaw': start_yaw,
        }.items(),
    )

    mapping_nodes = [
        Node(package='my_pakage', executable='lidar_image_creator', name='lidar_image_creator', output='screen'),
        Node(package='my_pakage', executable='lidar_processing', name='lidar_processing', output='screen'),
        Node(package='my_pakage', executable='cone_map_viz', name='cone_map_viz', output='screen'),
    ]

    control_nodes = [
        Node(
            package='my_pakage',
            executable='path_planner_bridge',
            name='path_planner_bridge',
            output='screen',
            parameters=[{
                'map_topic': '/ldlidar_node/cons_map',
                'pose_topic': '/pose',
                'path_topic': '/path_planning/waypoints',
                'mission': 'trackdrive',
                'experimental_performance_improvements': False,
                'min_cone_count': 1,
                'timer_period_sec': 0.1,
                'planner_scale': 10.0,
            }],
        ),
        Node(
            package='my_pakage',
            executable='path_follower',
            name='path_follower',
            output='screen',
            parameters=[{
                'path_topic': '/path_planning/waypoints',
                'pose_topic': '/pose',
                'steering_topic': 'target_angle',
                'speed_topic': 'target_speed',
                'lookahead': 0.2,
                'wheelbase': 0.18,
                'max_steer_rad': MAX_STEER,
                'target_speed': 0.75,
            }],
        ),
    ]

    return [car_simulator_include, *mapping_nodes, *control_nodes]
