Efrieza7/Cotxe_autonom/(commit log)

2026-04-06 comit de prova
2026-04-12 0.2.0 Creacio de IMU suscriber
2026-04-12 comentari de que el node de imu_subscriver no esta testejat. S'ha de crear el publisher i mirar que tot funicioni
2026-04-12 creacio de una V0 del readme
2026-04-14 0.3.0 primera versio de un EKF-slam
2026-04-20 0.4.0 prototip imu transformada pre TF2
2026-05-02 0.4.0 Integracio lidar mitjançant ia
    [LD19.stl]
2026-06-14 1.0.0 Primer model de cracio de mapa
2026-07-24 2.0.0 Control de direccio i velocitat, i proba de maping. Primer codi funcional
2026-07-29 2.0.1 Restructuracio de codi
    [LD19.stl]
2026-08-18 2.1.0 millora de la localitsacio
    [LD19.stl]
2026-08-18 2.1.1 Fi dels problemes amb github
    [LD19.stl]
2026-08-19 2.1.2: afegir variable per activar i controlar la reducció d'error en la posicio utilitzant el lidar
2026-08-22 Afegir codi de papalotis, algoritme de pathplan.
    Queda pendent afeegir en node de ros2 per a poder utilitzar les funcions i la compatibilitat amb la resta del codi
2026-08-23 Canvi de noms
2026-09-17 Primera versio d'un simulador
    [car.urdf]
2026-09-17 uns petits cambis per acabar de configurar-ho tot
2026-09-17 uns petits camis per acabar de posar el simulador abunt
2026-09-17 3.1.0 creacio de archius de launch
2026-09-17 3.1.1 Compliment condicions de us
2026-09-20 Refine bridge edge-case handling
2026-09-22 3.2.0 Primera prova existosa amb el simulador
2026-09-22 s'ha afegit nou mapa amb un traçat realisata i un escalat adecuat al del cotxe de veritat, he cambiat les dimencions del cotxe i he fet que el cotxe que comença a 0,0 estigui centrat al mig del circu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
2026-09-24 preparar el merge
2026-09-24 4.0.0: Versio final de codi validada en simulació
    [car.urdf, cone.stl, gt3_body.stl, gt3_cabin.stl]
2026-10-04 test servo
2026-10-05 4.1.0 afegit el document modificacions estetiques
2026-10-08 4.2.0 Solucio a calcul de velocitat i altres detalls
2026-10-09 Pin servo motor
2026-10-09 2n intent pin servo
2026-10-11 4.2.1 adaptacio de pins
2026-10-11 modificar pins motors
2026-10-12 He afegit una prova pels motors i el el README.m hi ha les instruccions per fer funcionar la gpio amb ubuntu
2026-10-12 pantalla sempre engegaa i leds d'estat
2026-10-12 solucio leds
2026-10-12 fallo motor
2026-10-21 Arreglo problema leds
2026-10-21 arreglo motors
2026-10-23 Calibrat del servo
2026-10-23 lidar rotat
2026-10-23 solucio caigudes de tensio
2026-10-24 Canvi pin servo
2026-10-24 no se que es aixo
2026-10-24 canvi força motors
2026-10-24 nou calibrat temporal
2026-10-25 calibrat de les rodes
2026-10-25 caolcul servo amb presisio
2026-10-26 calibrat servo
2026-10-27 calibrat invertit
2026-10-27 cambis a la direccio i s'ha afegit foxglove
2026-10-27 canbvi de target speed
2026-10-27 intent de que els motors donin mes força a vaixa velositat
2026-10-27 pid mes agresiu
2026-10-27 canvi en el path
2026-10-27 canvi de velositat
2026-10-28 mapa nou de bcn i eina per girar les rodes
2026-10-28 canvi de la geometria akerman
2026-10-29 nou calibrat
2026-10-29 calibrat post 3r braç
2026-10-29 restaurat avans de ahir a la nit
2026-10-29 Keep 35 cm from wall when only one side is detected
2026-11-10 Engega el cotxe en arrencar amb el botó del joystick (LEDs blaus mentre espera)
    start_car llegeix el joystick de la Sense HAT directament (/dev/input),
    amb --loop torna a esperar en acabar i el botó atura el launch.
    Servei car-launcher.service + install_car_launcher.sh.
2026-11-10 status_led: detecta el launch també per car_moving (a vegades no arriben els noms dels nodes)
